MeckMan2025/LawnBot/electronics/BOM.csv

category | item | qty | spec | notes
motion | goBILDA 5203 Yellow Jacket planetary gearmotor | 2 | 71.2:1, 84 rpm, 8 mm REX shaft, encoder | Part 5203-2402-0071. One per drive wheel.
motion | 8 mm REX shaft extension | 2 | 120 mm long, goBILDA 2101 series | Runs through the axle housing bore to the wheel hub.
motion | 8 mm REX clamping shaft coupler | 2 | REX to REX, max 18 mm OD | Sits inside the axle housing's 20 mm bore. Joins the motor shaft to the extension.
motion | goBILDA Hyper Hub | 2 | 8 mm REX bore, 16 mm M4 pattern | Part 1310-0016-4008. Bolts to the drive wheel's outer web.
motion | RoboClaw 2x15A motor controller | 1 | 2 channels, encoder inputs, USB/serial | One channel per drive wheel.
bearings | 6808-2RS ball bearing | 4 | 40 x 52 x 7 | Two per drive wheel, in the printed hub.
bearings | 6004-2RS ball bearing | 4 | 20 x 42 x 12 | Two per caster spindle tower.
bearings | 51104 thrust bearing | 2 | 20 x 35 x 10 | One per caster, between the yoke crown and the boom arm pad.
bearings | 608-2RS ball bearing | 4 | 8 x 22 x 7 | Two per caster wheel.
compute | Raspberry Pi 5 | 1 | 8 GB, with active cooler and 64 GB microSD | Runs the robot software.
compute | 5 V 5 A buck converter | 1 | 12 V in, 5 V 5 A out, USB-C or screw terminals | Powers the Pi 5. Pololu D36V50F5 or similar.
sensing | Luxonis OAK-D Pro W | 1 | wide FOV, active IR | Obstacle depth, night vision, on-device detection. Mounts on the canopy nose.
sensing | u-blox ZED-F9P RTK GPS board | 1 | SparkFun GPS-RTK2 or Ardusimple simpleRTK2B | 2 cm positioning with NTRIP corrections.
sensing | GPS antenna | 1 | u-blox ANN-MB-00 multi-band, 60 mm puck | Sits in the printed cup on the mast.
sensing | BNO085 IMU breakout | 1 | I2C | Heading and motion.
sensing | Raspberry Pi Camera Module 3 Wide | 1 | with 300 mm ribbon cable | In the pan-tilt housing.
sensing | IR illuminator | 1 | 850 nm, 12 V, 10 mm LED or small board | Beside the camera window.
sensing | Subminiature microswitch | 2 | 20 x 10 x 6.5 mm, lever | In the bumper carrier pockets.
motion | Standard-size servo | 2 | 20 kg.cm, 40 x 20 x 40 mm, metal gear | Pan and tilt.
power | LiFePO4 battery | 1 | 12.8 V 20 Ah, max 180 x 150 x 75 mm, built-in BMS | Lies flat in the tray on the chassis lid.
power | LiFePO4 charger | 1 | 14.6 V, 5 A or more | For the dock supply.
power | Mushroom E-stop button | 1 | 22 mm, NC contact | On the canopy roof, rear right.
power | Automotive relay | 1 | 12 V coil, 30 A contacts | E-stop cuts motor power through this.
power | Inline fuse holder and fuses | 1 | 30 A blade fuse | Battery positive lead.
power | Spring contact plates | 2 | 10 x 30 mm, gold or nickel plated | In the charge port housing; mate with the dock block.
power | Copper or brass contact strips | 2 | 20 x 4 mm | In the dock contact block.
power | XT60 connectors | 4 | pairs | Battery and motor power.
power | WAGO 221 lever connectors | 10 | 3 and 5 way | Power distribution.
io | 12 V LED strip | 1 | 180 mm, warm white, IP65 | In the light bar housing.
io | Piezo buzzer | 1 | 12 V, 12 mm | Through the light bar housing.
io | PG9 cable glands | 5 | nylon, 4 to 8 mm cable | Enclosure walls.
io | Gamepad | 1 | Bluetooth or USB | Teleop during setup.
fasteners | M12 x 180 hex bolt with nylock nut and washers | 2 | 8.8 steel | Caster spindle core.
fasteners | M8 x 140 hex bolt with nylock nut and washers | 2 | 8.8 steel | Caster axle.
fasteners | M6 x 50 socket cap | 8 | stainless | Caster towers into the arm pad inserts.
fasteners | M5 x 45 socket cap with nut | 12 | stainless | Cross member splices and arm-to-cross bolts.
fasteners | M5 x 35 socket cap with nut | 8 | stainless | Axle housing through the wall into the motor mount.
fasteners | M5 x 30 socket cap | 4 | stainless | Riser tops into the cross member.
fasteners | M5 x 25 socket cap | 4 | stainless | Mast base through the roof into the standoff.
fasteners | M5 x 20 socket cap with nut | 32 | stainless | Chassis module seams (16) and dock tiles (16).
fasteners | M5 x 16 socket cap | 24 | stainless | Riser, leg and brace feet; deck to cross members.
fasteners | M4 x 45 socket cap with nut | 6 | stainless | Mast cross bolts.
fasteners | M4 x 16 socket cap | 24 | stainless | Motor faces, enclosure lid, fenders.
fasteners | M4 x 12 socket cap | 70 | stainless | Chassis lids, skirts, enclosure feet, standoff, tray, hood.
fasteners | M3 x 8 socket cap | 40 | stainless | Canopy splice strips.
fasteners | M3 x 10 socket cap | 16 | stainless | E-stop housing, light bar, tilt bracket, board adapter plates.
fasteners | M2.5 x 8 socket cap | 4 | stainless | Raspberry Pi 5.
fasteners | M2 x 6 socket cap | 4 | stainless | Camera module.
fasteners | Heat-set insert M2.5 | 4 | 3.4 mm hole | Enclosure floor (Pi).
fasteners | Heat-set insert M3 | 70 | 4.0 mm hole | Enclosure grid, canopy splices, camera housing.
fasteners | Heat-set insert M4 | 120 | 5.6 mm hole | Lids, deck grid, skirts, tub bosses, fenders.
fasteners | Heat-set insert M5 | 70 | 6.4 mm hole | Lids, cross members, legs, standoff, dock tiles.
fasteners | Heat-set insert M6 | 8 | 8.0 mm hole | Arm pads for the caster towers.
fasteners | Compression spring | 2 | 10 mm OD, 30 mm long, light | Bumper return.
fasteners | M5 x 30 shoulder bolt | 2 | 6 mm shoulder | Bumper carrier slides on these.
fasteners | Nylon strap with buckle | 2 | 25 mm wide | Battery.
fasteners | Ground stake | 4 | 10 mm, 200 mm long | Dock tiles.
misc | AprilTag print | 1 | tag36h11, 120 mm, laminated | In the dock tag frame.
misc | Silicone sealant | 1 | clear, outdoor | Camera window, gland threads.
misc | Dielectric grease | 1 | small tube | Charge contacts.
