MeckMan2025/LawnBot/cad/out/assembly.step

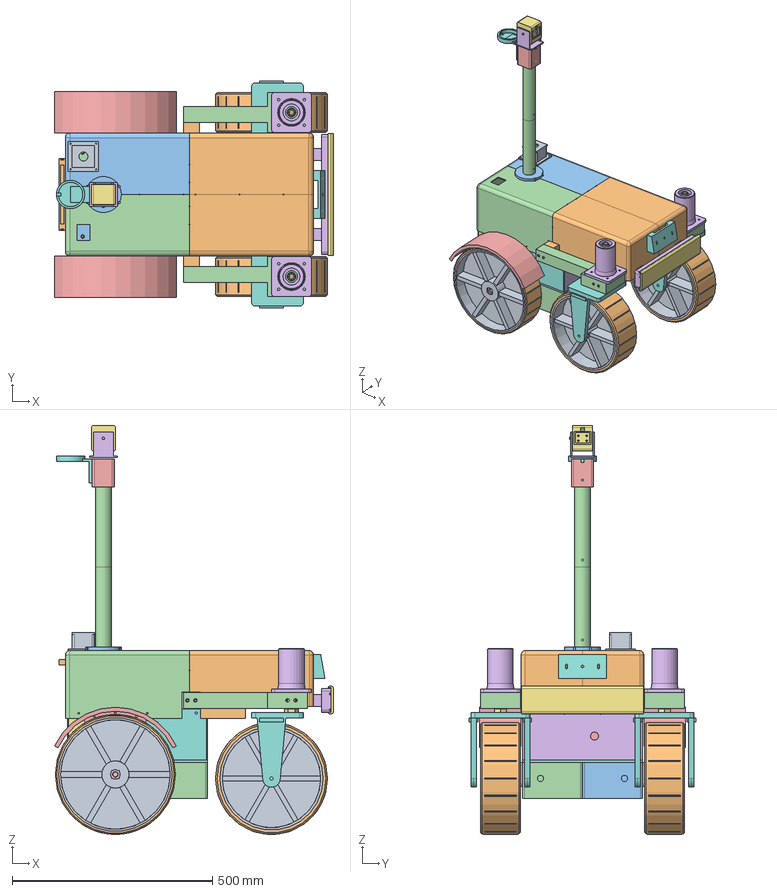
[picture p1: CAD file, 2026-10-13]
cad/out/assembly.step
697.3 x 566.0 x 1022.0 mm
rear_left
rear_right
front_left
front_right
motor_mount_left
axle_housing_left
motor_mount_right
axle_housing_right
lid_rear
lid_front
wheel_left
tread_left
wheel_right
tread_right
leg_left
leg_right
battery_tray
skirt_rear
skirt_front
skirt_side_rear_left
skirt_side_front_left
skirt_side_rear_right
skirt_side_front_right
riser_left
cross_rear_left
riser_right
cross_rear_right
brace_left
boom_arm_left
brace_right
boom_arm_right
cross_front_left
cross_front_right
tower_left
sleeve_left
fork_left
caster_rim_left
caster_tire_left
tower_right
sleeve_right
fork_right
caster_rim_right
caster_tire_right
deck_rear_right
deck_rear_left
deck_front_right
deck_front_left
enclosure_tub
enclosure_lid
mast_standoff
canopy_front_left
canopy_front_right
canopy_rear_left
canopy_rear_right
fender_left
fender_right
bumper_carrier
bumper_skin
oak_mount
estop_housing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
