MeckMan2025/LawnBot/cad/out/step/canopy_splice_roof_y.step

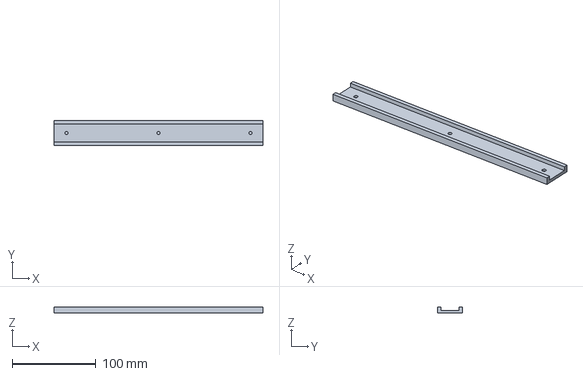
[picture p2: CAD file, 2026-10-12]
cad/out/step/canopy_splice_roof_y.step
250.0 x 30.0 x 7.00 mm
