MeckMan2025/LawnBot/cad/out/step/mast_standoff.step

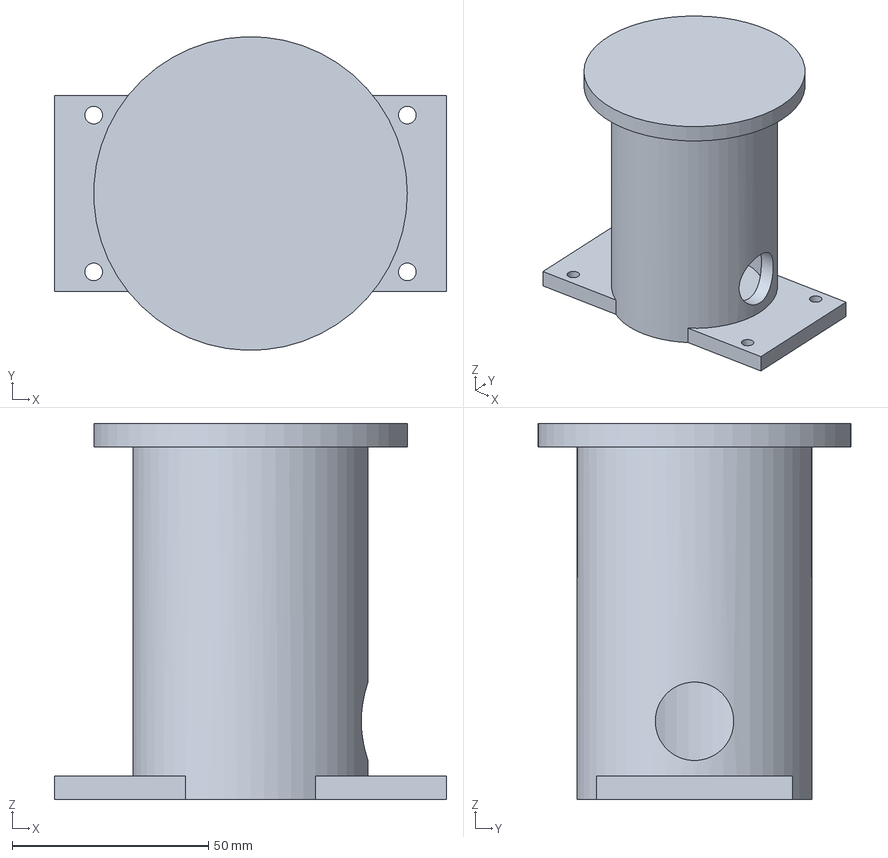
[picture p3: CAD file, 2026-10-12]
cad/out/step/mast_standoff.step
100.0 x 80.0 x 96.0 mm
