MeckMan2025/LawnBot/cad/out/step/riser_brace.step

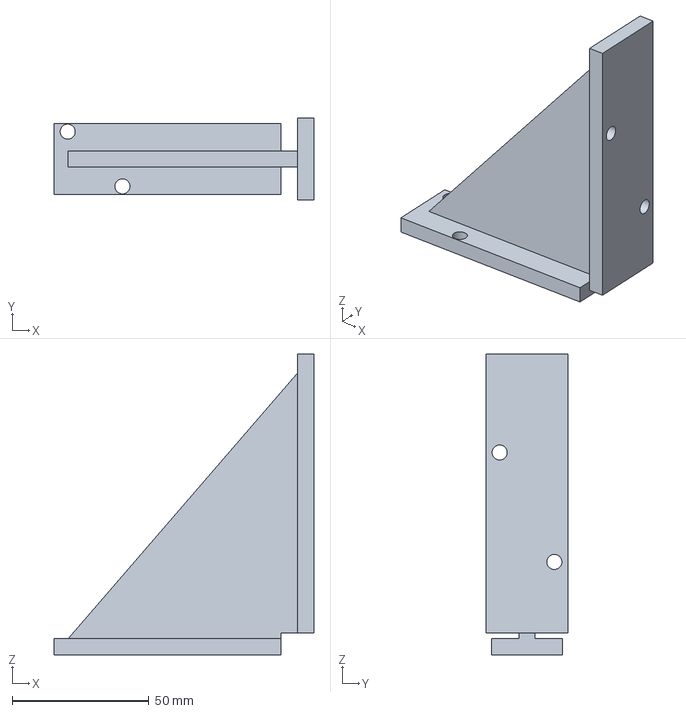
[picture p4: CAD file, 2026-10-12]
cad/out/step/riser_brace.step
95.0 x 30.0 x 110.0 mm
