MeckMan2025/LawnBot/cad/out/step/caster_axle_spacer_inner.step

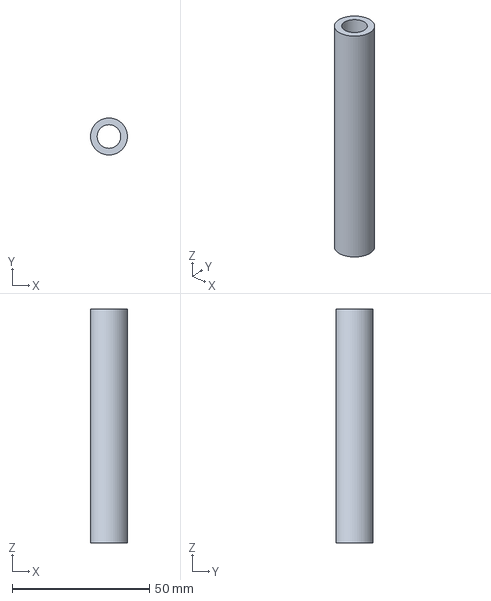
[picture p5: CAD file, 2026-10-12]
cad/out/step/caster_axle_spacer_inner.step
13.5 x 13.5 x 85.4 mm
