MeckMan2025/LawnBot/cad/out/step/drive_wheel.step

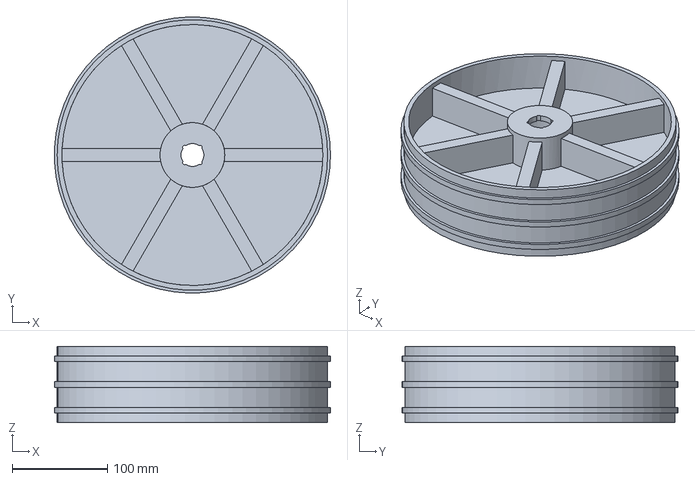
[picture p6: CAD file, 2026-10-12]
cad/out/step/drive_wheel.step
289.8 x 289.9 x 80.0 mm
