MeckMan2025/LawnBot/cad/out/step/dock_tile.step

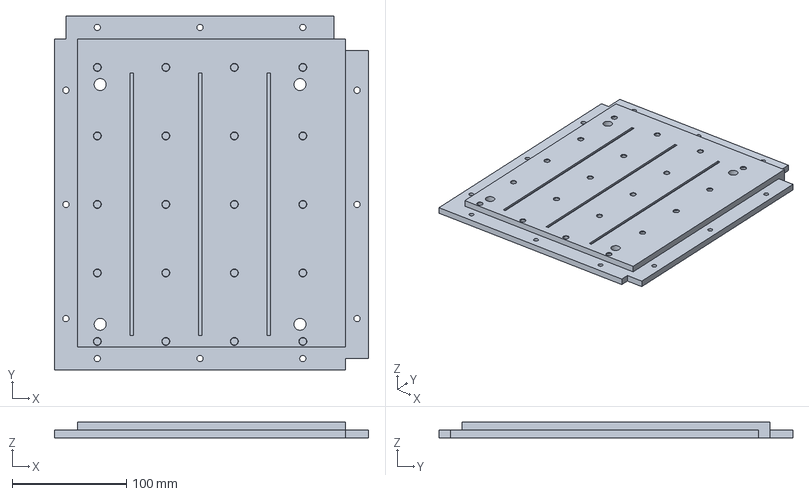
[picture p7: CAD file, 2026-10-12]
cad/out/step/dock_tile.step
275.0 x 310.0 x 14.0 mm
