MeckMan2025/LawnBot/cad/out/step/dock_rail_half.step

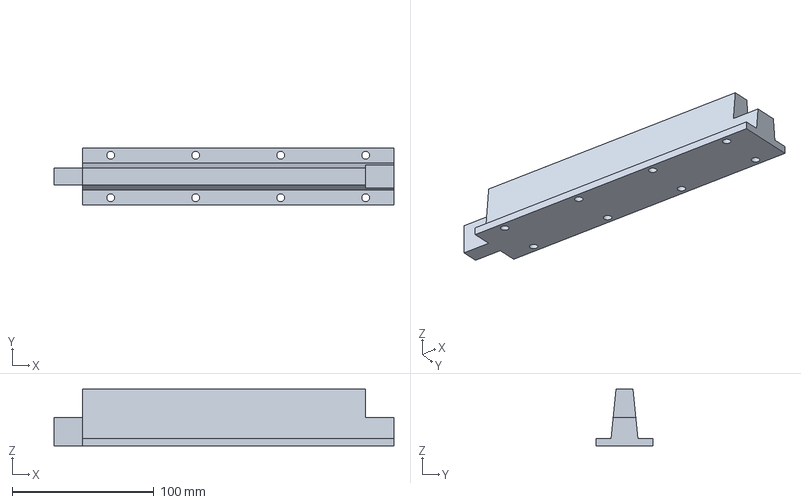
[picture p8: CAD file, 2026-10-12]
cad/out/step/dock_rail_half.step
240.0 x 40.0 x 40.0 mm
