MeckMan2025/LawnBot/cad/out/step/gps_mount.step

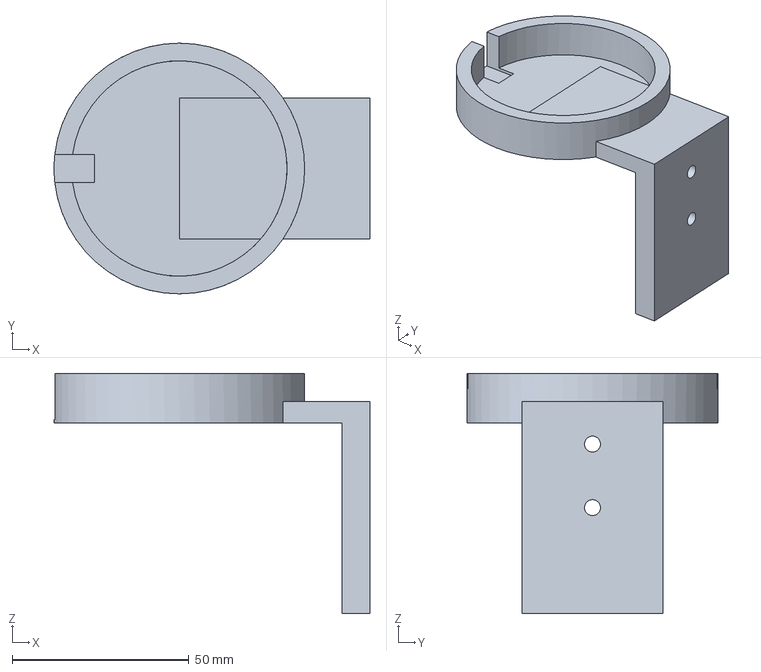
[picture p9: CAD file, 2026-10-12]
cad/out/step/gps_mount.step
89.5 x 71.0 x 68.0 mm
