MeckMan2025/LawnBot/cad/out/step/battery_tray.step

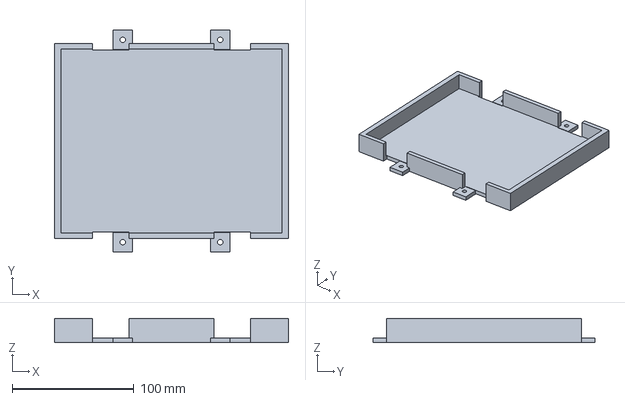
[picture p10: CAD file, 2026-10-12]
cad/out/step/battery_tray.step
192.0 x 182.0 x 20.0 mm
