MeckMan2025/LawnBot/cad/out/step/canopy_front_right.step

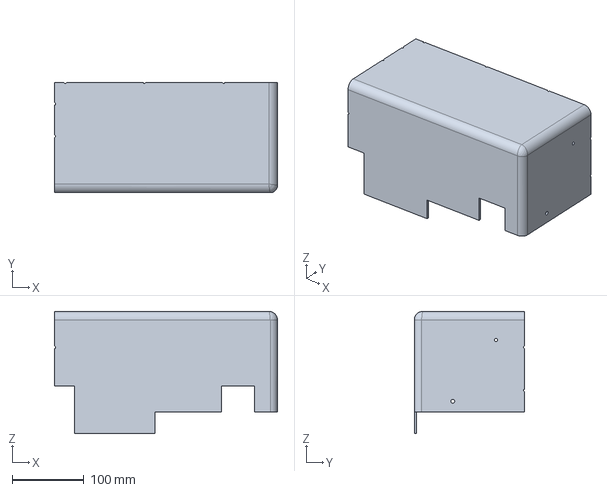
[picture p11: CAD file, 2026-10-12]
cad/out/step/canopy_front_right.step
310.0 x 153.5 x 170.0 mm
