MeckMan2025/LawnBot/cad/out/step/boom_cross_front_half.step

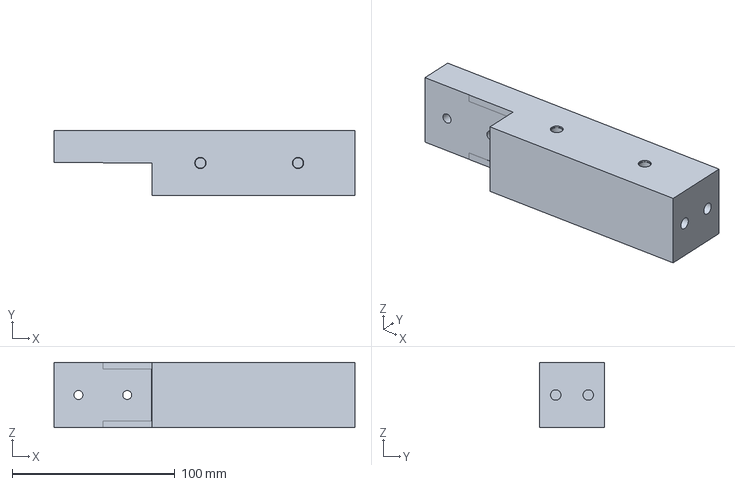
[picture p12: CAD file, 2026-10-12]
cad/out/step/boom_cross_front_half.step
185.0 x 40.0 x 40.0 mm
