MeckMan2025/LawnBot/cad/out/step/tilt_bracket.step

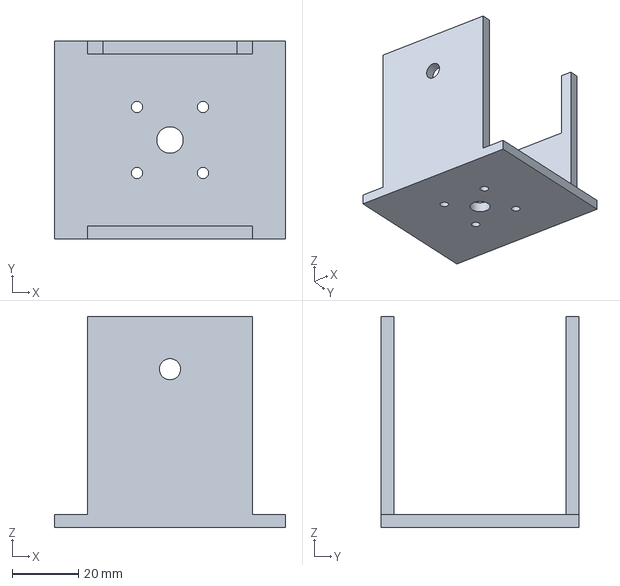
[picture p13: CAD file, 2026-10-12]
cad/out/step/tilt_bracket.step
70.0 x 60.0 x 64.0 mm
