MeckMan2025/LawnBot/cad/out/step/skirt_side_front.step

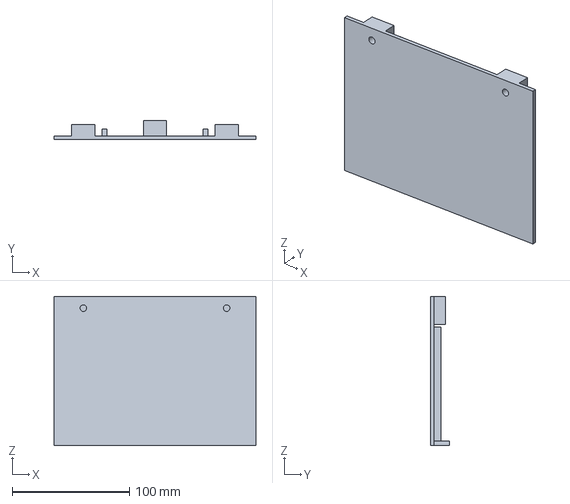
[picture p14: CAD file, 2026-10-12]
cad/out/step/skirt_side_front.step
172.0 x 16.5 x 127.0 mm
