MeckMan2025/LawnBot/cad/out/step/chassis_lid_rear.step

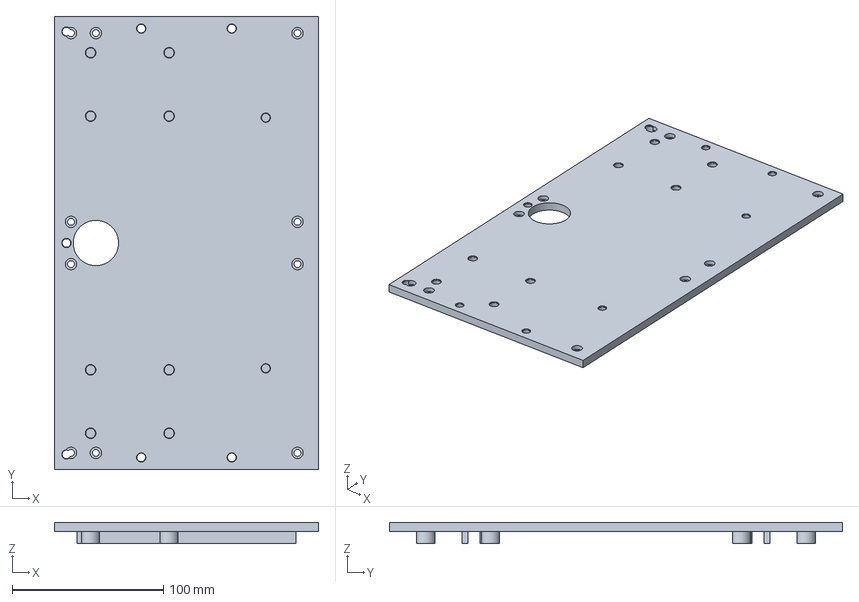
[picture p15: CAD file, 2026-10-12]
cad/out/step/chassis_lid_rear.step
175.0 x 300.0 x 14.0 mm
