MeckMan2025/LawnBot/cad/out/step/chassis_module_front_left.step

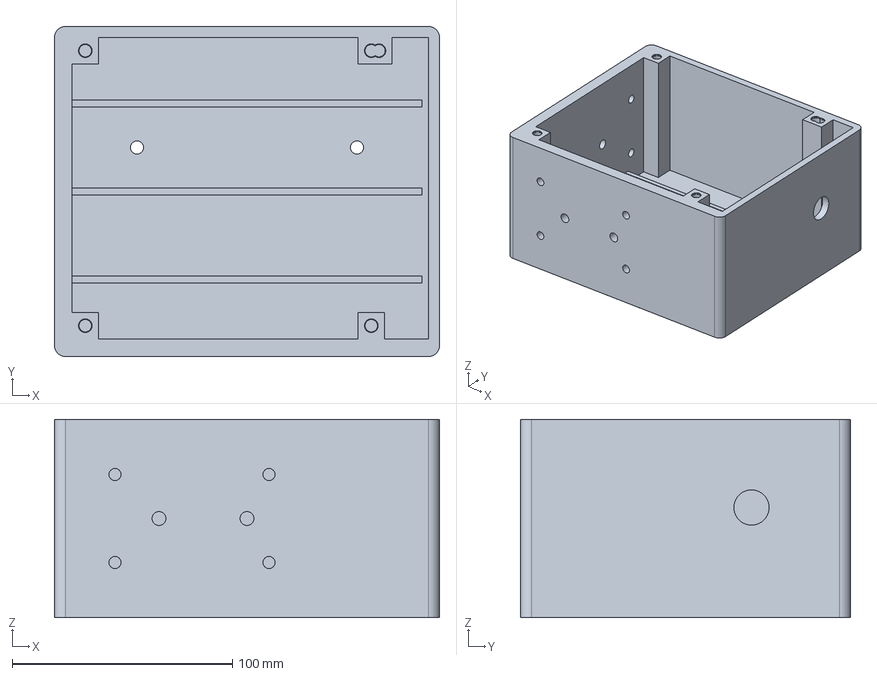
[picture p16: CAD file, 2026-10-12]
cad/out/step/chassis_module_front_left.step
175.0 x 150.0 x 90.0 mm
