MeckMan2025/LawnBot/cad/out/step/canopy_rear_left.step

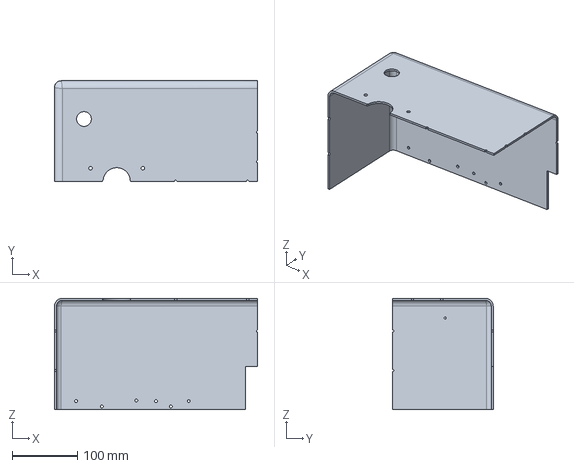
[picture p18: CAD file, 2026-10-12]
cad/out/step/canopy_rear_left.step
310.0 x 153.5 x 170.0 mm
