MeckMan2025/LawnBot/cad/out/step/fender.step

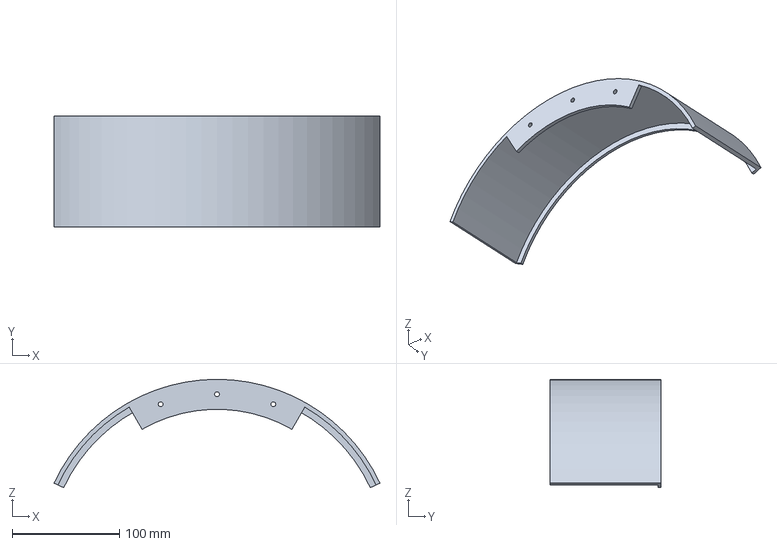
[picture p19: CAD file, 2026-10-12]
cad/out/step/fender.step
304.5 x 104.0 x 101.2 mm
