MeckMan2025/LawnBot/cad/out/step/enclosure_tub.step

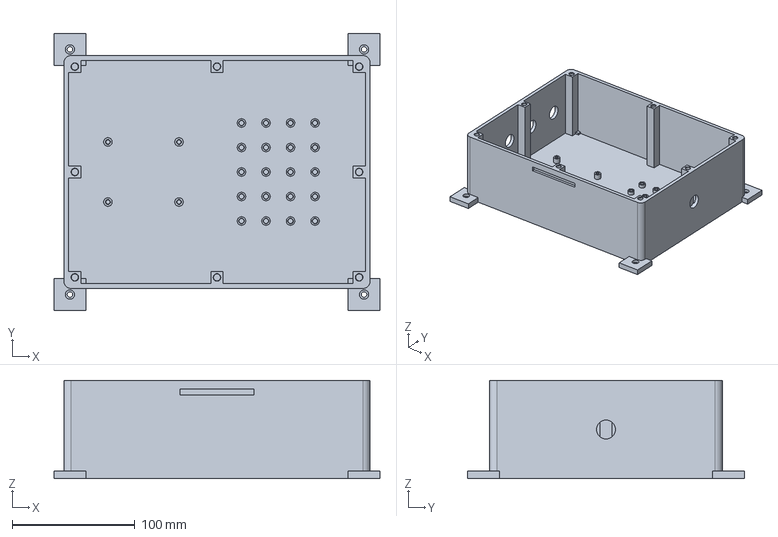
[picture p20: CAD file, 2026-10-12]
cad/out/step/enclosure_tub.step
266.0 x 226.0 x 80.0 mm
