MeckMan2025/LawnBot/cad/out/step/estop_housing.step

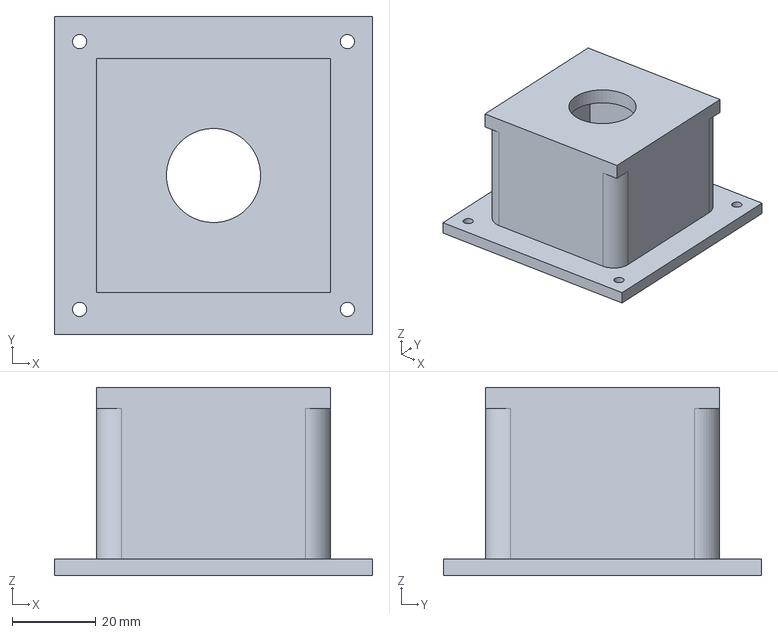
[picture p21: CAD file, 2026-10-12]
cad/out/step/estop_housing.step
76.0 x 76.0 x 45.0 mm
