MeckMan2025/LawnBot/cad/out/step/pan_base.step

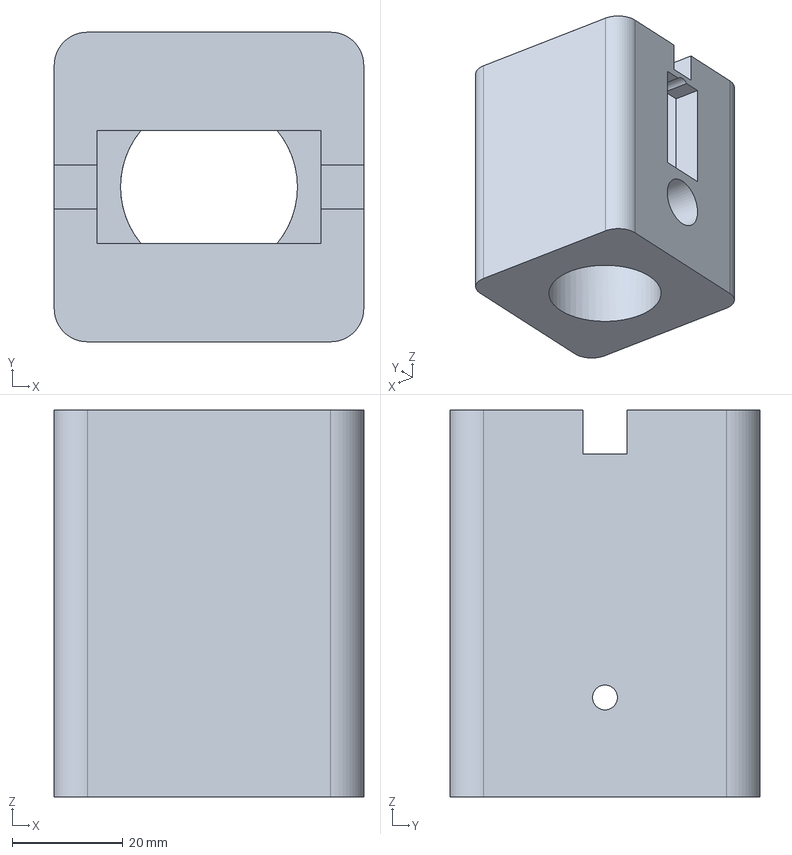
[picture p22: CAD file, 2026-10-12]
cad/out/step/pan_base.step
56.0 x 56.0 x 70.0 mm
