MeckMan2025/LawnBot/cad/out/step/dock_contact_block.step

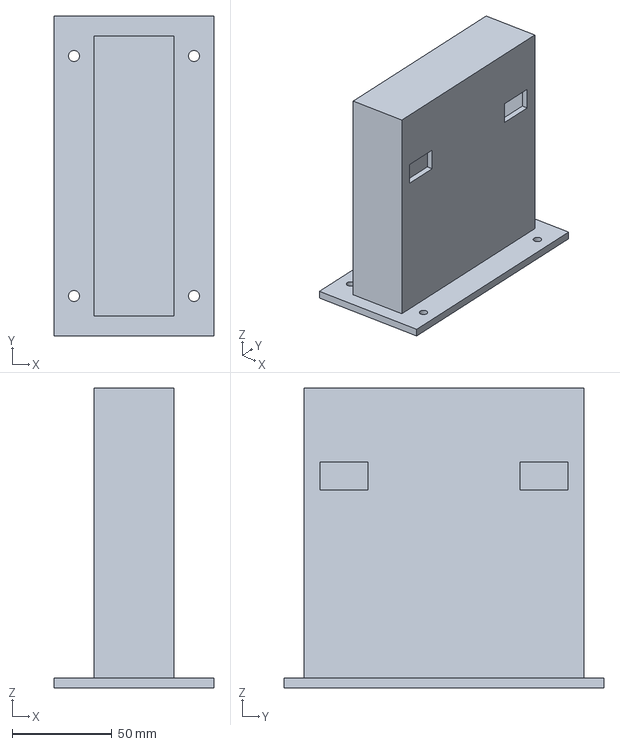
[picture p23: CAD file, 2026-10-12]
cad/out/step/dock_contact_block.step
80.0 x 160.0 x 150.0 mm
