MeckMan2025/LawnBot/cad/out/step/caster_rim.step

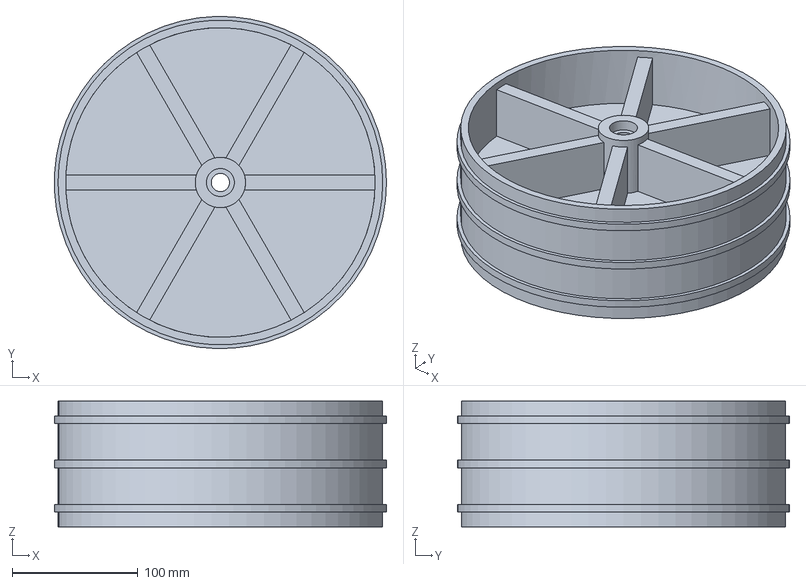
[picture p24: CAD file, 2026-10-12]
cad/out/step/caster_rim.step
263.8 x 263.9 x 100.0 mm
