MeckMan2025/LawnBot/cad/out/step/canopy_splice_wall.step

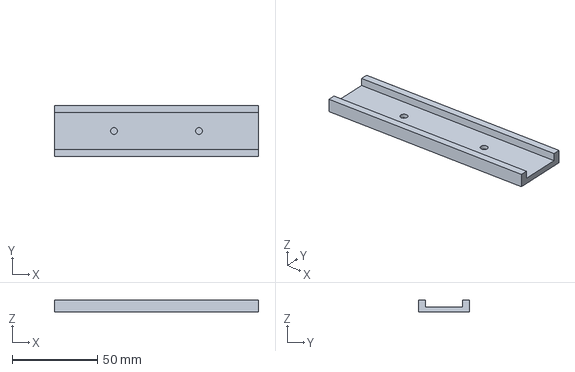
[picture p25: CAD file, 2026-10-12]
cad/out/step/canopy_splice_wall.step
120.0 x 30.0 x 7.00 mm
