MeckMan2025/LawnBot/cad/out/step/caster_fork.step

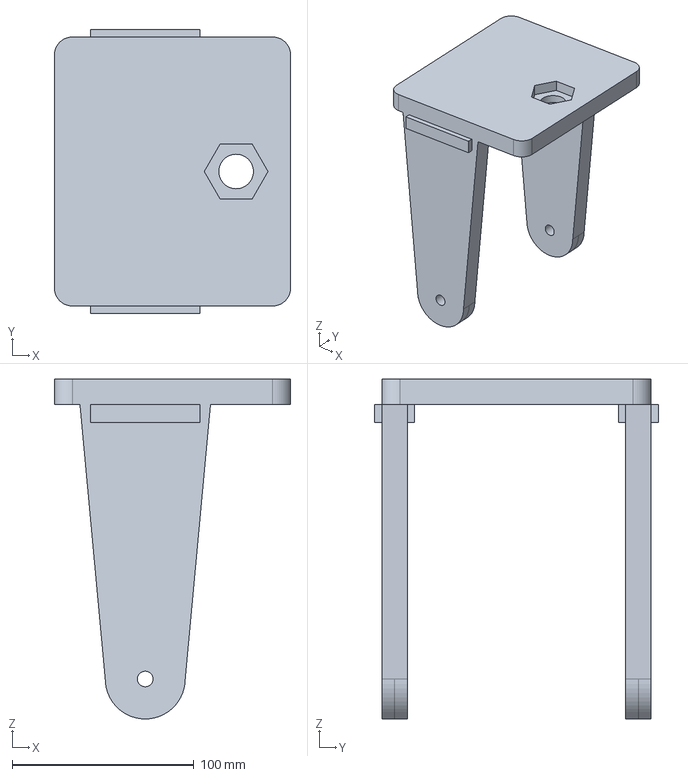
[picture p26: CAD file, 2026-10-12]
cad/out/step/caster_fork.step
130.0 x 156.0 x 187.0 mm
