MeckMan2025/LawnBot/cad/out/step/drive_axle_housing.step

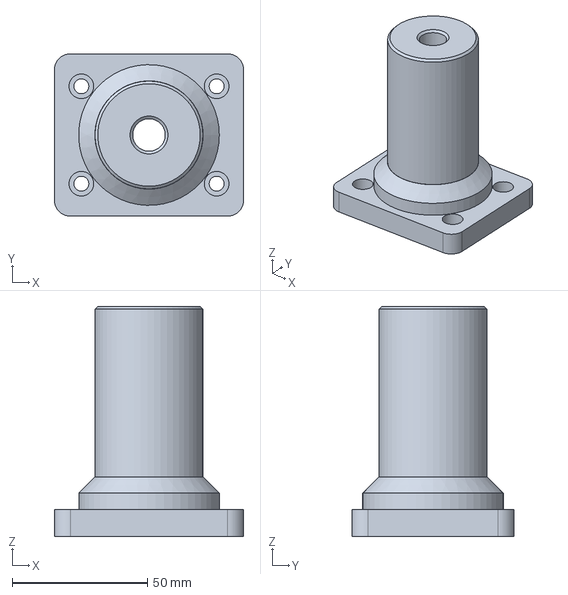
[picture p27: CAD file, 2026-10-12]
cad/out/step/drive_axle_housing.step
70.0 x 60.0 x 85.0 mm
