MeckMan2025/LawnBot/cad/out/step/boom_cross_rear_half.step

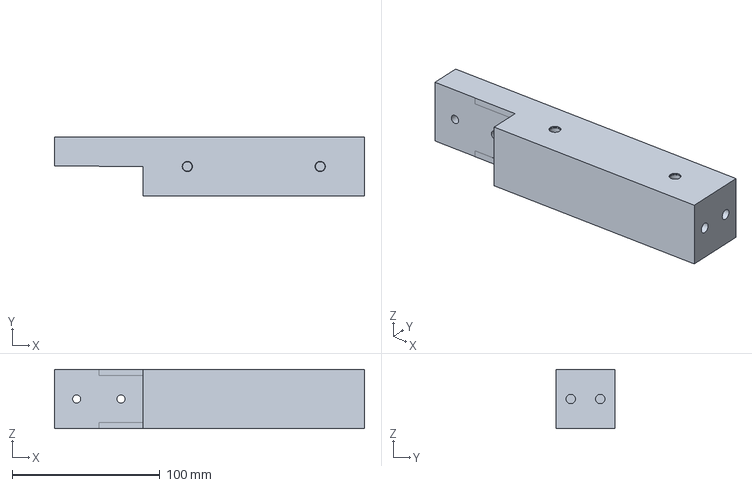
[picture p28: CAD file, 2026-10-12]
cad/out/step/boom_cross_rear_half.step
210.0 x 40.0 x 40.0 mm
