MeckMan2025/LawnBot/cad/out/step/alignment_dowel.step

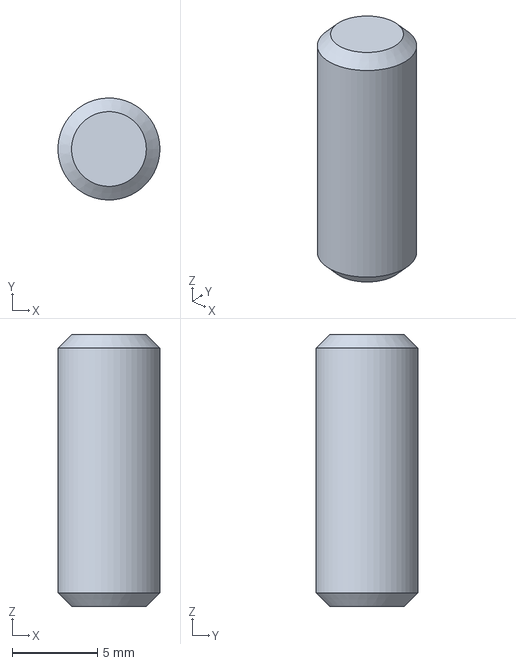
[picture p29: CAD file, 2026-10-12]
cad/out/step/alignment_dowel.step
5.99 x 6.00 x 16.0 mm
