MeckMan2025/LawnBot/cad/out/step/camera_cover.step

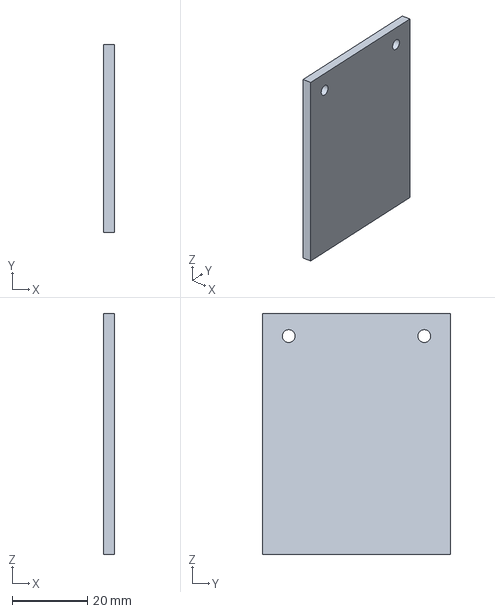
[picture p30: CAD file, 2026-10-12]
cad/out/step/camera_cover.step
3.00 x 50.0 x 64.0 mm
