MeckMan2025/LawnBot/cad/out/step/mast_base.step

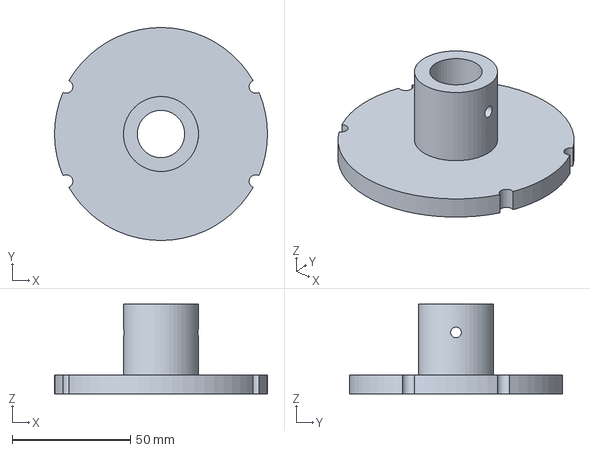
[picture p31: CAD file, 2026-10-12]
cad/out/step/mast_base.step
90.0 x 90.0 x 38.0 mm
