MeckMan2025/LawnBot/cad/out/step/rear_deck_leg.step

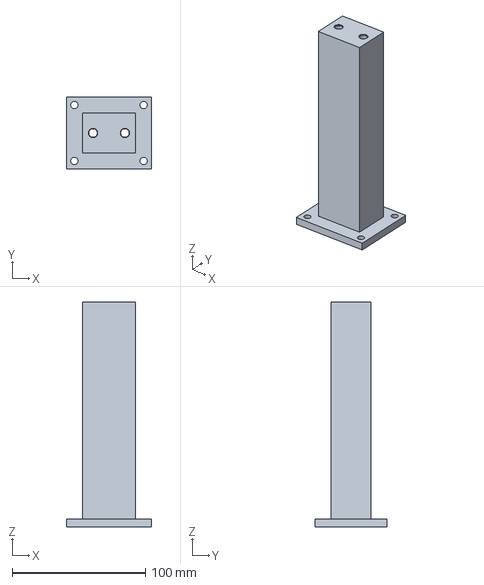
[picture p32: CAD file, 2026-10-12]
cad/out/step/rear_deck_leg.step
64.0 x 54.0 x 169.0 mm
