MeckMan2025/LawnBot/cad/out/step/bumper_skin.step

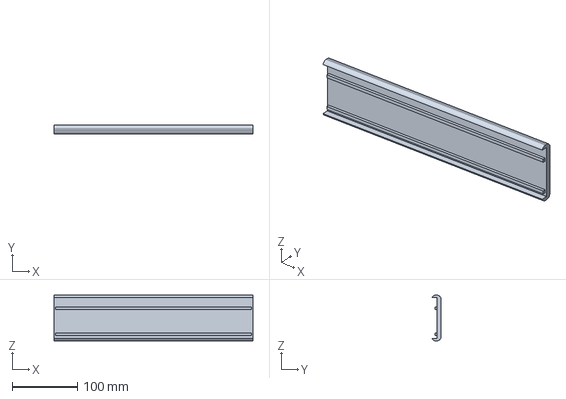
[picture p33: CAD file, 2026-10-12]
cad/out/step/bumper_skin.step
304.0 x 13.7 x 70.0 mm
