MeckMan2025/LawnBot/cad/out/step/enclosure_lid.step

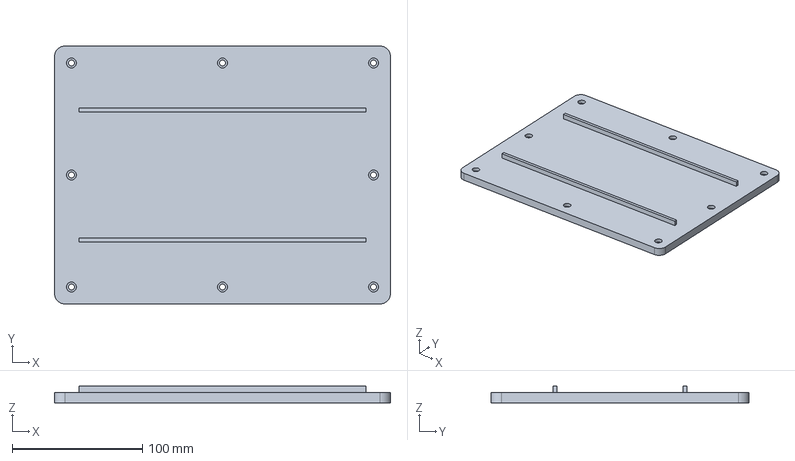
[picture p34: CAD file, 2026-10-12]
cad/out/step/enclosure_lid.step
258.0 x 198.0 x 13.0 mm
