MeckMan2025/LawnBot/cad/out/step/caster_tire.step

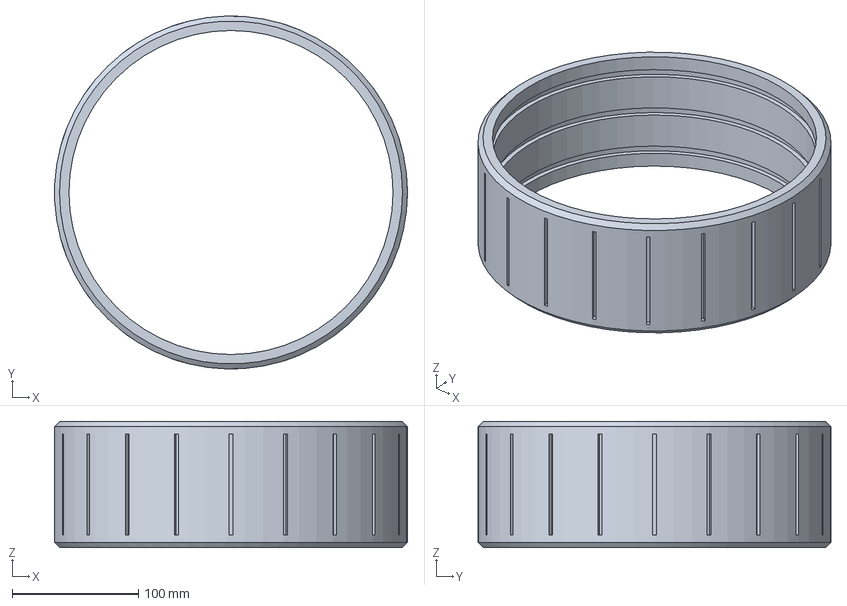
[picture p35: CAD file, 2026-10-12]
cad/out/step/caster_tire.step
280.0 x 280.0 x 100.0 mm
