MeckMan2025/LawnBot/cad/out/step/camera_housing.step

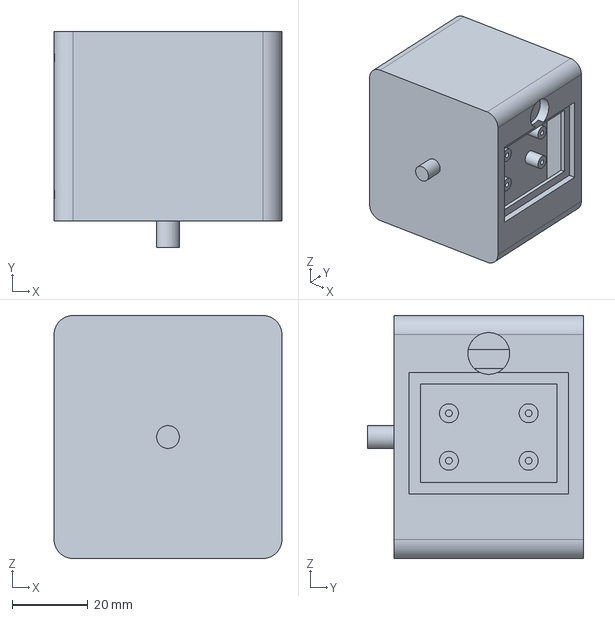
[picture p36: CAD file, 2026-10-12]
cad/out/step/camera_housing.step
60.0 x 57.0 x 64.0 mm
