MeckMan2025/LawnBot/cad/out/step/contact_pad_carrier.step

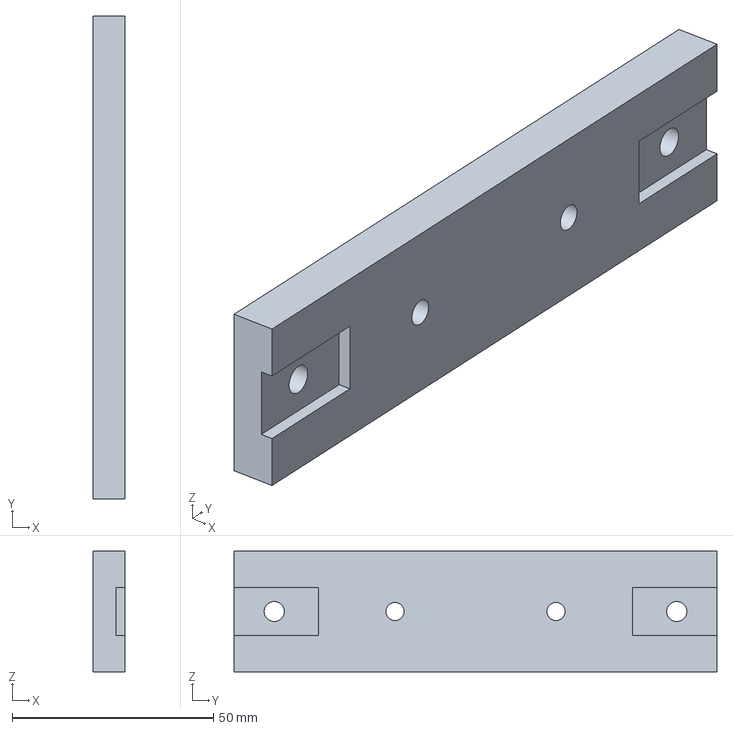
[picture p37: CAD file, 2026-10-12]
cad/out/step/contact_pad_carrier.step
8.00 x 120.0 x 30.0 mm
