MeckMan2025/LawnBot/cad/out/step/light_bar_housing.step

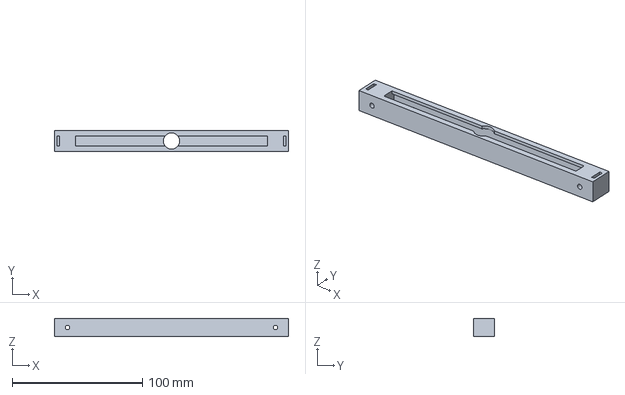
[picture p38: CAD file, 2026-10-12]
cad/out/step/light_bar_housing.step
180.0 x 16.0 x 14.0 mm
