MeckMan2025/LawnBot/cad/out/step/deck_front_right.step

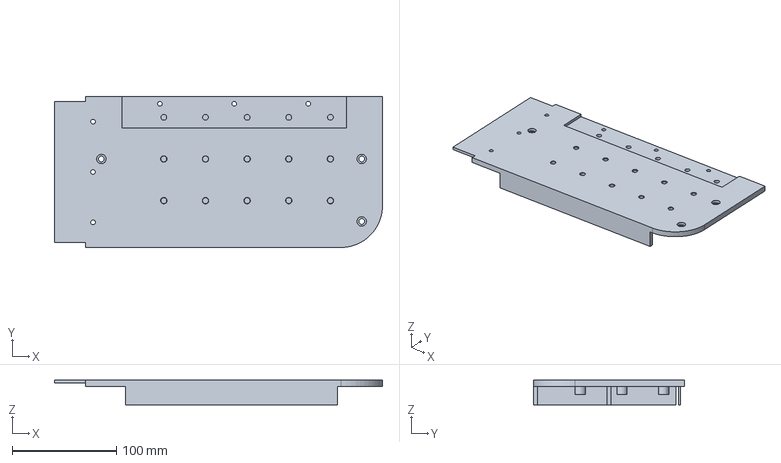
[picture p39: CAD file, 2026-10-12]
cad/out/step/deck_front_right.step
315.0 x 145.0 x 24.0 mm
