MeckMan2025/LawnBot/cad/out/step/boom_arm_right.step

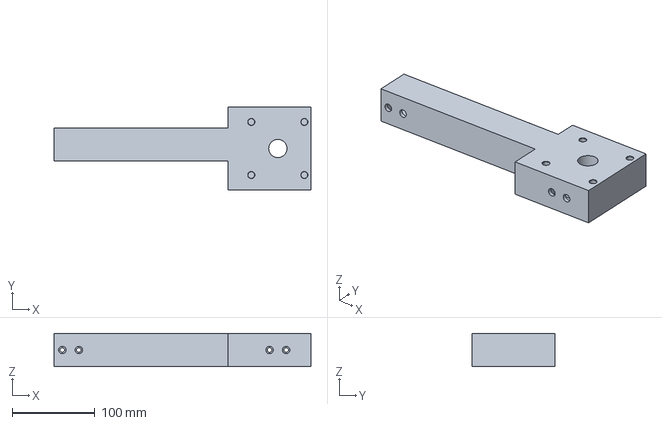
[picture p40: CAD file, 2026-10-12]
cad/out/step/boom_arm_right.step
310.0 x 100.0 x 40.0 mm
