MeckMan2025/LawnBot/cad/out/step/bearing_spacer.step

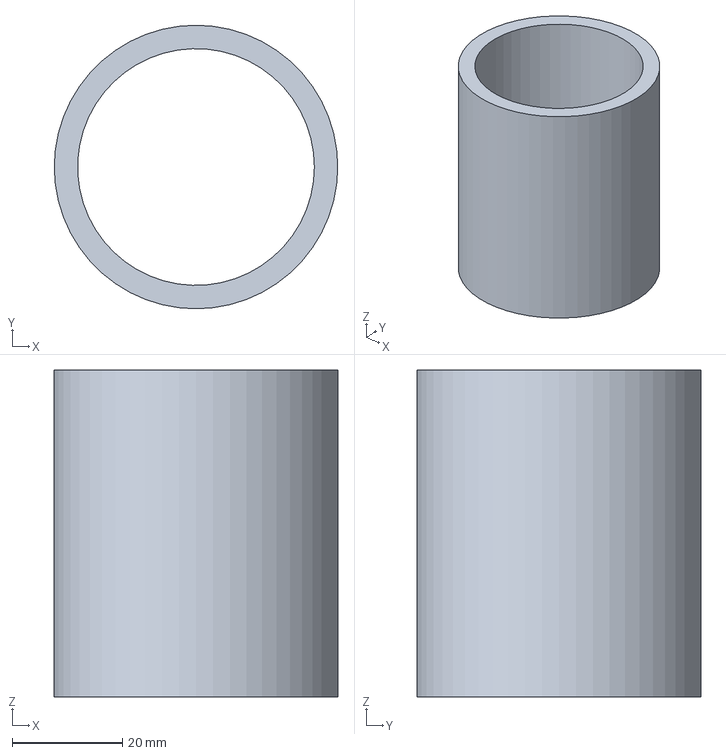
[picture p41: CAD file, 2026-10-12]
cad/out/step/bearing_spacer.step
51.5 x 51.5 x 59.4 mm
