MeckMan2025/LawnBot/cad/out/step/oak_hood.step

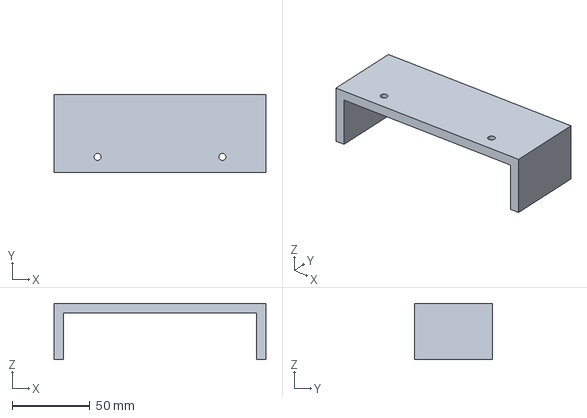
[picture p42: CAD file, 2026-10-12]
cad/out/step/oak_hood.step
136.0 x 50.0 x 36.0 mm
