MeckMan2025/LawnBot/cad/out/step/bumper_carrier.step

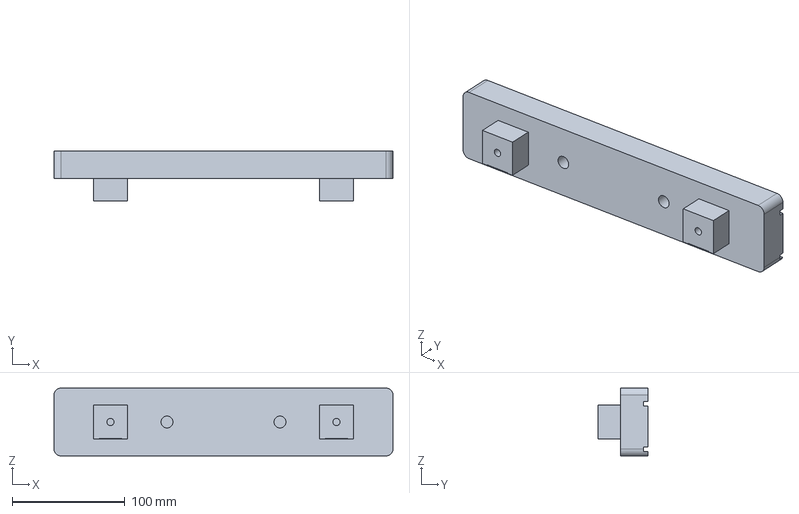
[picture p43: CAD file, 2026-10-12]
cad/out/step/bumper_carrier.step
300.0 x 44.0 x 60.0 mm
