MeckMan2025/LawnBot/cad/out/step/enclosure_gasket.step

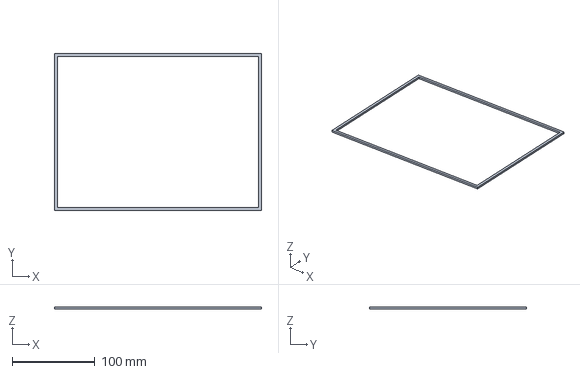
[picture p44: CAD file, 2026-10-12]
cad/out/step/enclosure_gasket.step
249.6 x 189.6 x 2.60 mm
