MeckMan2025/LawnBot/cad/out/step/caster_spindle_tower.step

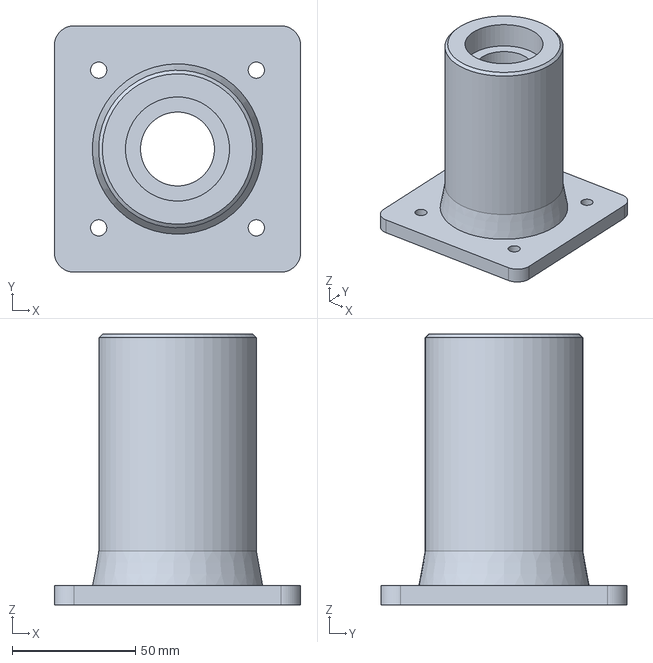
[picture p45: CAD file, 2026-10-12]
cad/out/step/caster_spindle_tower.step
100.0 x 100.0 x 110.0 mm
