MeckMan2025/LawnBot/cad/out/step/charge_port_housing.step

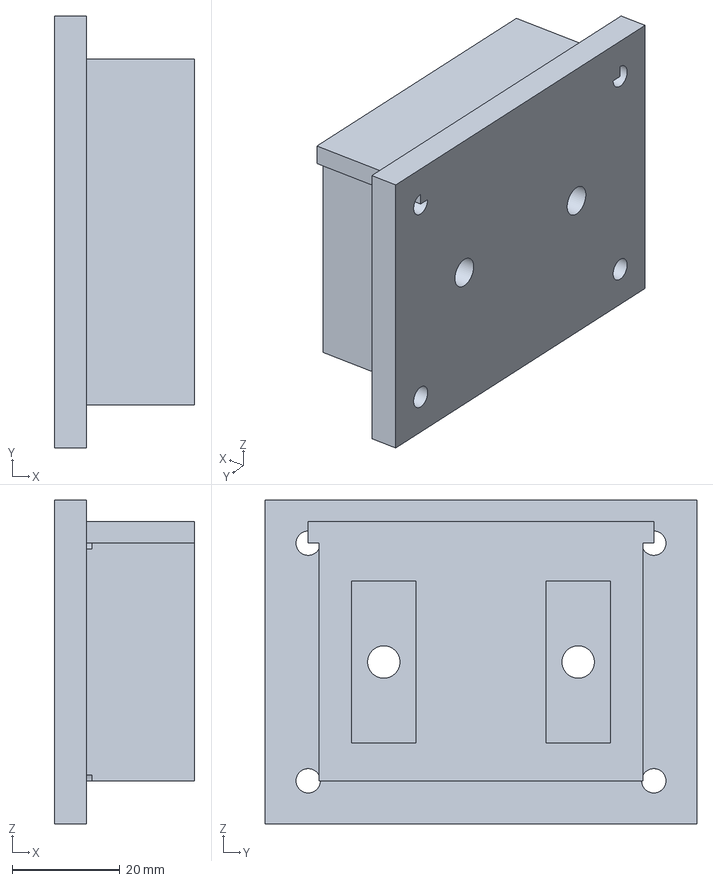
[picture p46: CAD file, 2026-10-12]
cad/out/step/charge_port_housing.step
26.0 x 80.0 x 60.0 mm
