MeckMan2025/LawnBot/cad/out/step/dock_rain_cover.step

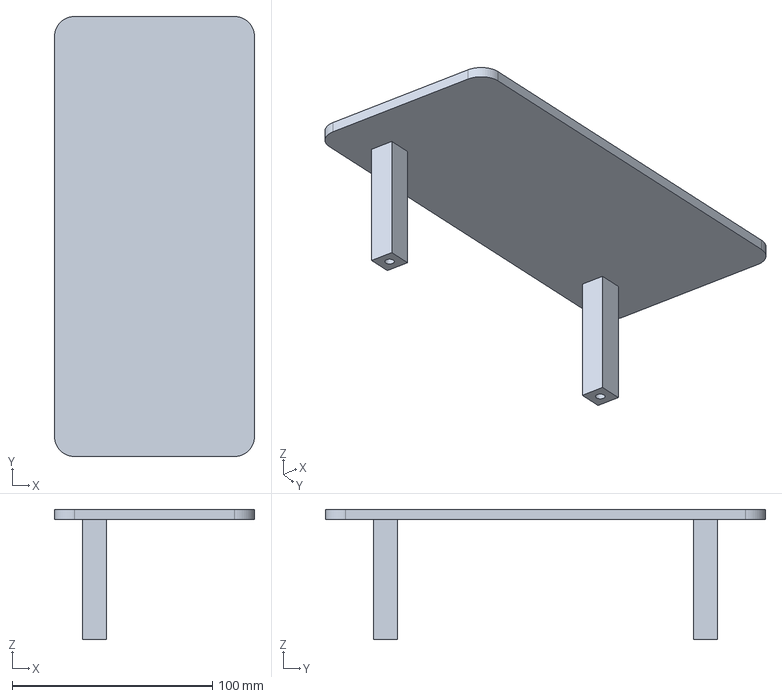
[picture p47: CAD file, 2026-10-12]
cad/out/step/dock_rain_cover.step
100.0 x 220.0 x 65.0 mm
