MeckMan2025/LawnBot/cad/out/step/riser_column.step

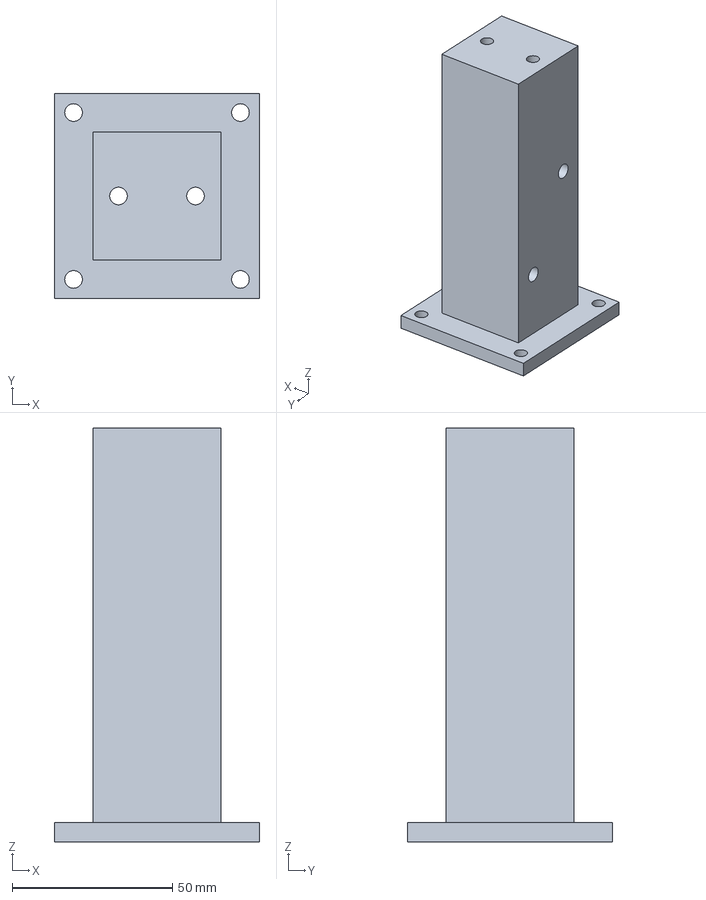
[picture p48: CAD file, 2026-10-12]
cad/out/step/riser_column.step
64.0 x 64.0 x 129.0 mm
