MeckMan2025/LawnBot/cad/out/step/oak_mount.step

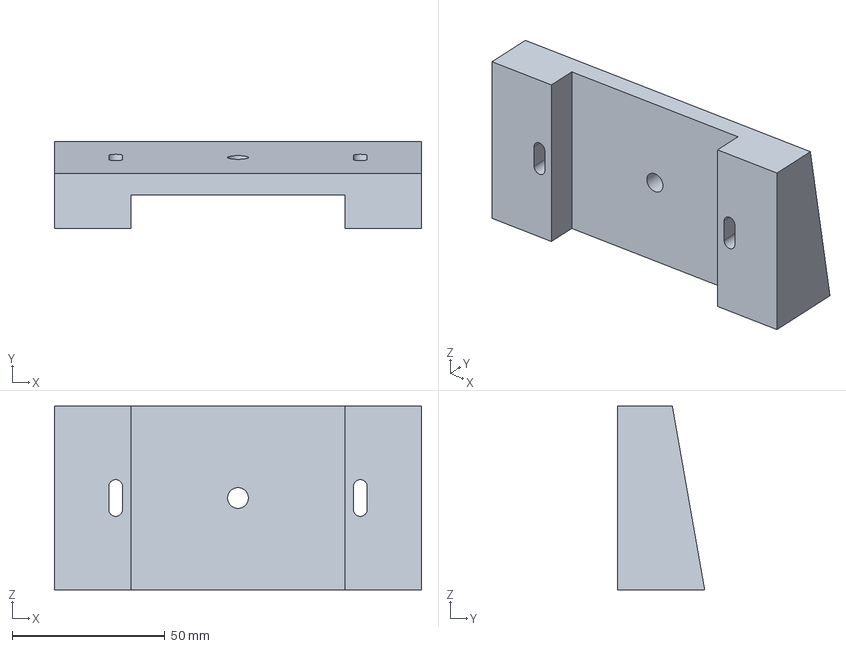
[picture p49: CAD file, 2026-10-12]
cad/out/step/oak_mount.step
120.0 x 28.6 x 60.0 mm
