MeckMan2025/LawnBot/cad/out/step/skirt_side_rear.step

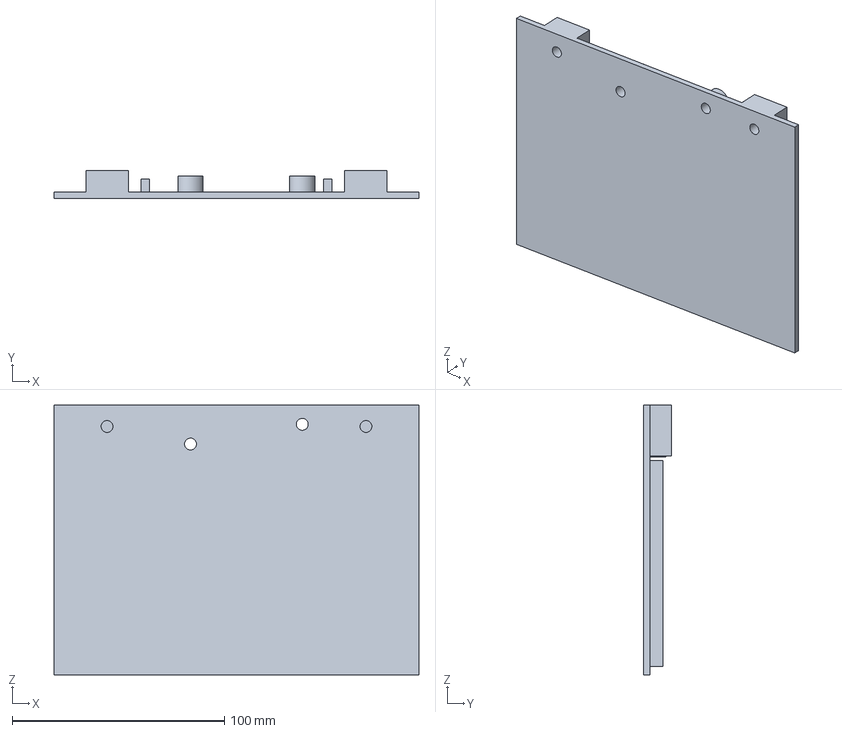
[picture p50: CAD file, 2026-10-12]
cad/out/step/skirt_side_rear.step
172.0 x 13.0 x 127.0 mm
