MeckMan2025/LawnBot/cad/out/step/deck_front_left.step

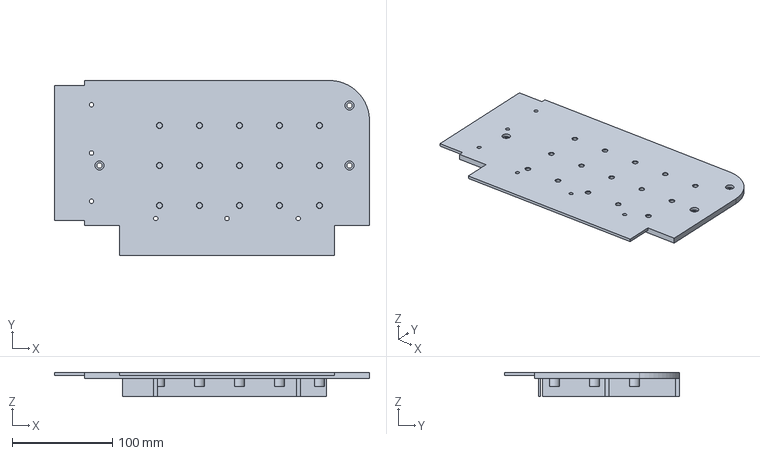
[picture p52: CAD file, 2026-10-12]
cad/out/step/deck_front_left.step
315.0 x 175.0 x 24.0 mm
