MeckMan2025/LawnBot/cad/out/step/dock_tag_frame.step

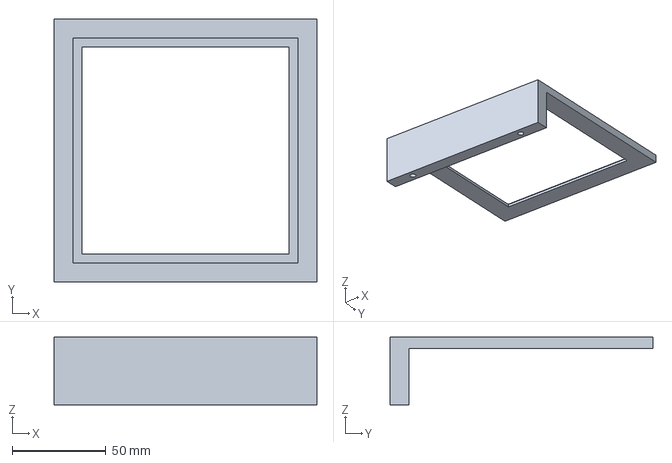
[picture p53: CAD file, 2026-10-12]
cad/out/step/dock_tag_frame.step
140.0 x 140.0 x 36.0 mm
