MeckMan2025/LawnBot/cad/out/step/camera_window.step

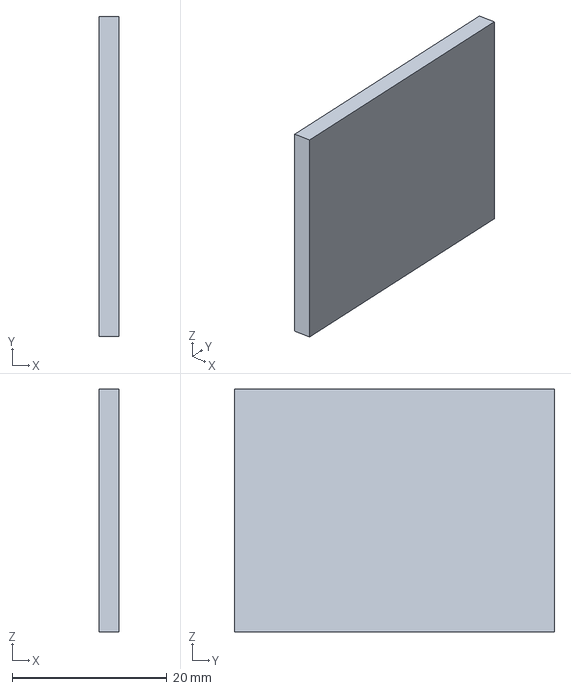
[picture p54: CAD file, 2026-10-12]
cad/out/step/camera_window.step
2.60 x 41.4 x 31.4 mm
