MeckMan2025/LawnBot/cad/out/step/deck_rear_left.step

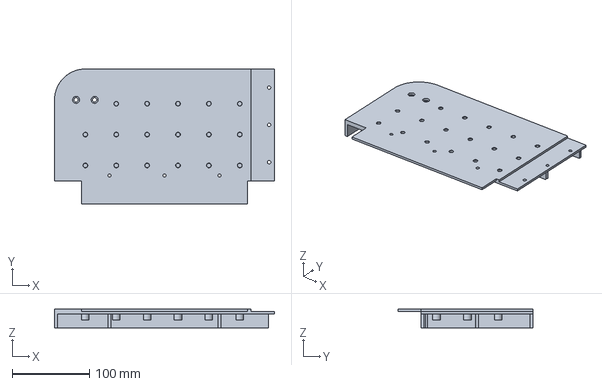
[picture p55: CAD file, 2026-10-12]
cad/out/step/deck_rear_left.step
285.0 x 175.0 x 24.0 mm
