MeckMan2025/LawnBot/cad/out/step/mast_segment.step

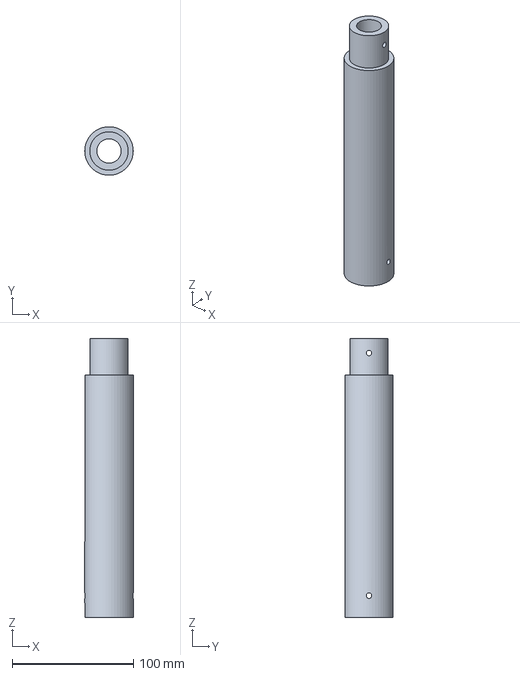
[picture p56: CAD file, 2026-10-12]
cad/out/step/mast_segment.step
40.0 x 40.0 x 230.0 mm
