MeckMan2025/LawnBot/cad/out/step/caster_spindle_sleeve.step

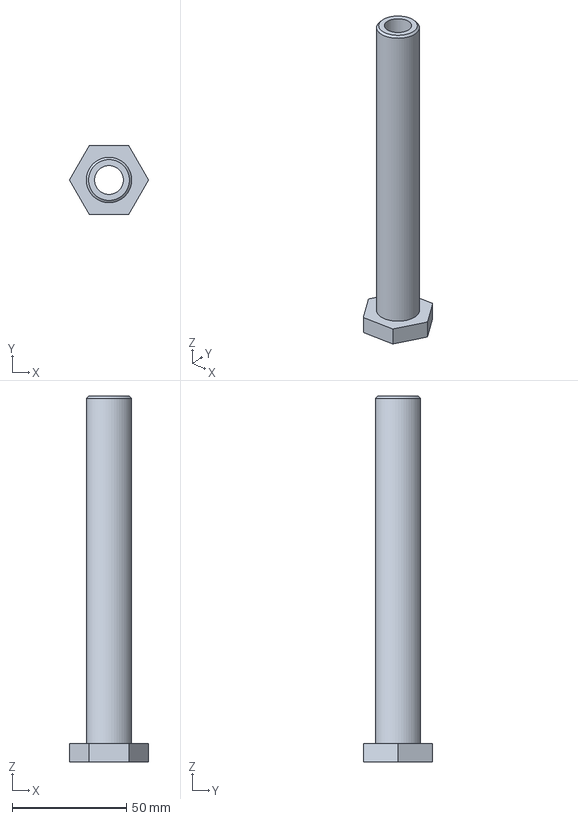
[picture p57: CAD file, 2026-10-12]
cad/out/step/caster_spindle_sleeve.step
34.6 x 30.0 x 160.0 mm
