MeckMan2025/LawnBot/cad/out/step/caster_axle_spacer_outer.step

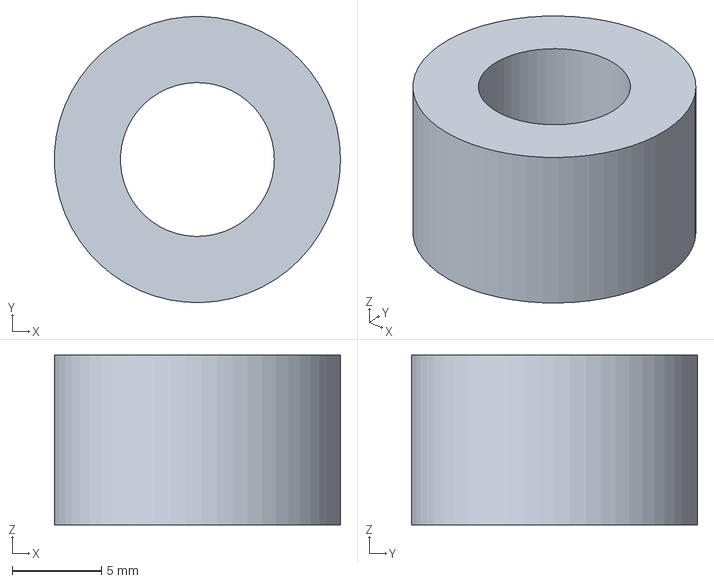
[picture p58: CAD file, 2026-10-12]
cad/out/step/caster_axle_spacer_outer.step
16.0 x 16.0 x 9.50 mm
