MeckMan2025/LawnBot/cad/out/step/skirt_rear.step

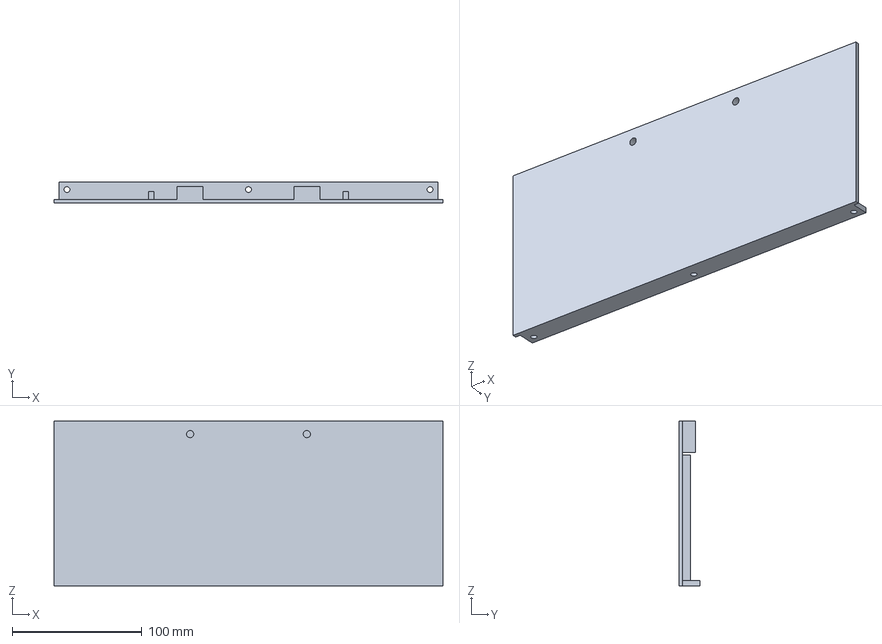
[picture p59: CAD file, 2026-10-12]
cad/out/step/skirt_rear.step
300.0 x 16.5 x 127.0 mm
