MeckMan2025/LawnBot/cad/out/step/deck_rear_right.step

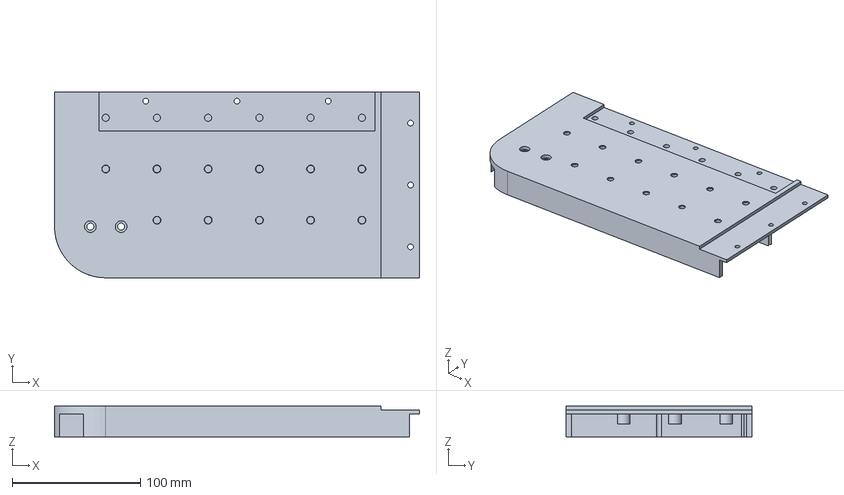
[picture p60: CAD file, 2026-10-12]
cad/out/step/deck_rear_right.step
285.0 x 145.0 x 24.0 mm
