MeckMan2025/LawnBot/cad/out/step/motor_mount_bracket.step

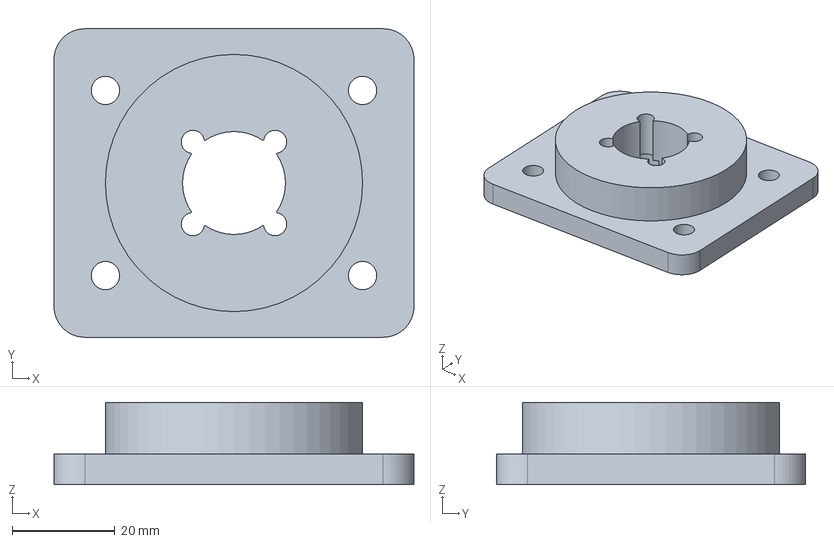
[picture p61: CAD file, 2026-10-12]
cad/out/step/motor_mount_bracket.step
70.0 x 60.0 x 16.0 mm
