MeckMan2025/LawnBot/cad/out/step/drive_tread.step

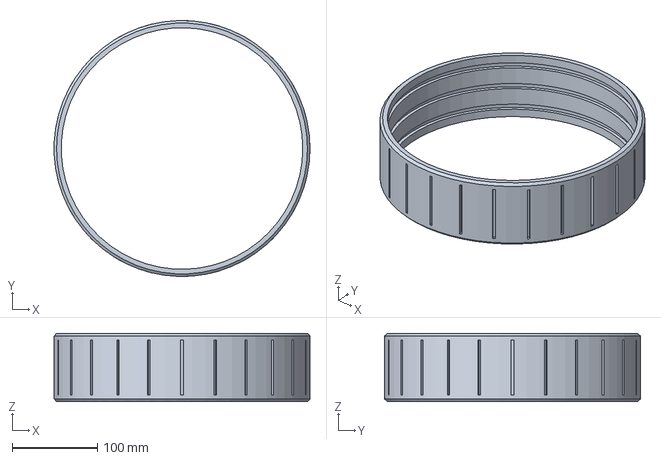
[picture p62: CAD file, 2026-10-12]
cad/out/step/drive_tread.step
300.0 x 300.0 x 80.0 mm
