MeckMan2025/LawnBot/(list of files, cad)

Other CAD files:
cad/out/step/chassis_module_front_right.step
cad/out/step/chassis_module_rear_left.step
cad/out/step/boom_arm_left.step
cad/out/step/canopy_rear_right.step
cad/out/step/canopy_front_left.step
cad/out/step/chassis_lid_front.step
cad/out/step/chassis_module_rear_right.step
cad/out/assembly.stl
cad/out/stl/alignment_dowel.stl
cad/out/stl/battery_tray.stl
cad/out/stl/bearing_spacer.stl
cad/out/stl/boom_arm_left.stl
cad/out/stl/boom_arm_right.stl
cad/out/stl/boom_cross_front_half.stl
cad/out/stl/boom_cross_rear_half.stl
cad/out/stl/bumper_carrier.stl
cad/out/stl/bumper_skin.stl
cad/out/stl/camera_cover.stl
cad/out/stl/camera_housing.stl
cad/out/stl/camera_window.stl
cad/out/stl/canopy_front_left.stl
cad/out/stl/canopy_front_right.stl
cad/out/stl/canopy_rear_left.stl
cad/out/stl/canopy_rear_right.stl
cad/out/stl/canopy_splice_roof_x.stl
cad/out/stl/canopy_splice_roof_y.stl
cad/out/stl/canopy_splice_wall.stl
cad/out/stl/caster_axle_spacer_inner.stl
cad/out/stl/caster_axle_spacer_outer.stl
cad/out/stl/caster_fork.stl
cad/out/stl/caster_rim.stl
cad/out/stl/caster_spindle_sleeve.stl
cad/out/stl/caster_spindle_tower.stl
cad/out/stl/caster_tire.stl
cad/out/stl/charge_port_housing.stl
cad/out/stl/chassis_lid_front.stl
cad/out/stl/chassis_lid_rear.stl
cad/out/stl/chassis_module_front_left.stl
cad/out/stl/chassis_module_front_right.stl
cad/out/stl/chassis_module_rear_left.stl
cad/out/stl/chassis_module_rear_right.stl
cad/out/stl/contact_pad_carrier.stl
cad/out/stl/deck_front_left.stl
cad/out/stl/deck_front_right.stl
cad/out/stl/deck_rear_left.stl
cad/out/stl/deck_rear_right.stl
cad/out/stl/dock_contact_block.stl
cad/out/stl/dock_rail_half.stl
cad/out/stl/dock_rain_cover.stl
cad/out/stl/dock_tag_frame.stl
cad/out/stl/dock_tile.stl
cad/out/stl/drive_axle_housing.stl
cad/out/stl/drive_tread.stl
cad/out/stl/drive_wheel.stl
cad/out/stl/enclosure_gasket.stl
cad/out/stl/enclosure_lid.stl
cad/out/stl/enclosure_tub.stl
cad/out/stl/estop_housing.stl
cad/out/stl/fender.stl
cad/out/stl/gps_mount.stl
cad/out/stl/light_bar_housing.stl
cad/out/stl/mast_base.stl
cad/out/stl/mast_segment.stl
cad/out/stl/mast_standoff.stl
cad/out/stl/motor_mount_bracket.stl
cad/out/stl/oak_hood.stl
cad/out/stl/oak_mount.stl
cad/out/stl/pan_base.stl
cad/out/stl/rear_deck_leg.stl
cad/out/stl/riser_brace.stl
cad/out/stl/riser_column.stl
cad/out/stl/skirt_front.stl
cad/out/stl/skirt_rear.stl
cad/out/stl/skirt_side_front.stl
cad/out/stl/skirt_side_rear.stl
cad/out/stl/tilt_bracket.stl
