MeckMan2025/LawnBot/docs/assembly-audit.md

# Virtual assembly audit

Generated by `cad/audit.py`. 68 placed parts, 160 fasteners checked.

| Check | Result |
|---|---|
| Insertion sweeps (part can reach its position in build order) | 68 of 68 clear |
| Bolt holes line up through every joined part | 160 of 160 clear |
| Driver can reach the bolt head at that point in the build | 160 of 160 clear |

## Build order used

- Step 1:
  - rear_left (chassis_module_rear_left), from (0, 0, 1)
  - rear_right (chassis_module_rear_right), from (0, 0, 1)
  - front_left (chassis_module_front_left), from (0, 0, 1)
  - front_right (chassis_module_front_right), from (0, 0, 1)
- Step 2:
  - motor_mount_left (motor_mount_bracket), from (0, -1, 0)
  - axle_housing_left (drive_axle_housing), from (0, 1, 0)
  - motor_mount_right (motor_mount_bracket), from (0, 1, 0)
  - axle_housing_right (drive_axle_housing), from (0, -1, 0)
  - lid_rear (chassis_lid_rear), from (0, 0, 1)
  - lid_front (chassis_lid_front), from (0, 0, 1)
  - wheel_left (drive_wheel), from (0, 1, 0)
  - tread_left (drive_tread), from (0, 1, 0)
  - wheel_right (drive_wheel), from (0, -1, 0)
  - tread_right (drive_tread), from (0, -1, 0)
- Step 3:
  - leg_left (rear_deck_leg), from (0, 0, 1)
  - leg_right (rear_deck_leg), from (0, 0, 1)
  - battery_tray (battery_tray), from (0, 0, 1)
  - skirt_rear (skirt_rear), from (-1, 0, 0)
  - skirt_front (skirt_front), from (0, 0, 1)
  - skirt_side_rear_left (skirt_side_rear), from (0, 0, 1)
  - skirt_side_front_left (skirt_side_front), from (0, 0, 1)
  - skirt_side_rear_right (skirt_side_rear), from (0, 0, 1)
  - skirt_side_front_right (skirt_side_front), from (0, 0, 1)
- Step 4:
  - riser_left (riser_column), from (0, 0, 1)
  - cross_rear_left (boom_cross_rear_half), from (0, 0, 1)
  - riser_right (riser_column), from (0, 0, 1)
  - cross_rear_right (boom_cross_rear_half), from (0, 0, 1)
  - brace_left (riser_brace), from (0, 0, 1)
  - boom_arm_left (boom_arm_left), from (0, 0, 1)
  - brace_right (riser_brace), from (0, 0, 1)
  - boom_arm_right (boom_arm_right), from (0, 0, 1)
  - cross_front_left (boom_cross_front_half), from (0, 0, 1)
  - cross_front_right (boom_cross_front_half), from (0, 0, 1)
- Step 5:
  - tower_left (caster_spindle_tower), from (0, 0, 1)
  - sleeve_left (caster_spindle_sleeve), from (0, 0, -1)
  - fork_left (caster_fork), from (0, 0, -1)
  - caster_rim_left (caster_rim), from (1, 0, 0)
  - caster_tire_left (caster_tire), from (1, 0, 0)
  - tower_right (caster_spindle_tower), from (0, 0, 1)
  - sleeve_right (caster_spindle_sleeve), from (0, 0, -1)
  - fork_right (caster_fork), from (0, 0, -1)
  - caster_rim_right (caster_rim), from (1, 0, 0)
  - caster_tire_right (caster_tire), from (1, 0, 0)
- Step 6:
  - deck_rear_right (deck_rear_right), from (0, 0, 1)
  - deck_rear_left (deck_rear_left), from (0, 0, 1)
  - deck_front_right (deck_front_right), from (0, 0, 1)
  - deck_front_left (deck_front_left), from (0, 0, 1)
  - enclosure_tub (enclosure_tub), from (0, 0, 1)
  - enclosure_lid (enclosure_lid), from (0, 0, 1)
  - mast_standoff (mast_standoff), from (0, 0, 1)
- Step 7:
  - canopy_front_left (canopy_front_left), from (0, 0, 1)
  - canopy_front_right (canopy_front_right), from (0, 0, 1)
  - canopy_rear_left (canopy_rear_left), from (0, 0, 1)
  - canopy_rear_right (canopy_rear_right), from (0, 0, 1)
  - fender_left (fender), from (0, 0, 1)
  - fender_right (fender), from (0, 0, 1)
  - bumper_carrier (bumper_carrier), from (1, 0, 0)
  - bumper_skin (bumper_skin), from (1, 0, 0)
  - oak_mount (oak_mount), from (1, 0, 0)
  - estop_housing (estop_housing), from (0, 0, 1)
  - light_bar_housing (light_bar_housing), from (-1, 0, 0)
- Step 8:
  - mast_base (mast_base), from (0, 0, 1)
  - mast_segment_0 (mast_segment), from (0, 0, 1)
  - mast_segment_1 (mast_segment), from (0, 0, 1)
  - pan_base (pan_base), from (0, 0, 1)
  - tilt_bracket (tilt_bracket), from (0, 0, 1)
  - camera_housing (camera_housing), from (1, 0, 0)
  - gps_mount (gps_mount), from (-1, 0, 0)

## Fasteners checked

| Fastener | Size | Count |
|---|---|---|
| seam bolt (lateral) | M5 | 8 |
| seam bolt (longitudinal) | M5 | 8 |
| lid bolt | M4 | 20 |
| axle housing bolt | M5 | 8 |
| motor bolt | M4 | 8 |
| riser foot bolt | M5 | 8 |
| riser top bolt | M5 | 4 |
| brace foot bolt | M5 | 4 |
| brace to riser bolt | M5 | 4 |
| leg foot bolt | M5 | 8 |
| arm to rear cross bolt | M5 | 4 |
| arm pad to front cross bolt | M5 | 4 |
| cross splice bolt | M5 | 4 |
| tower bolt | M6 | 8 |
| spindle bolt (insert before the wheel) | M12 | 2 |
| caster axle bolt | M8 | 2 |
| deck to cross member bolt | M5 | 8 |
| deck to leg bolt | M5 | 4 |
| enclosure foot bolt | M4 | 4 |
| battery tray bolt | M4 | 4 |
| side skirt bolt | M4 | 8 |
| rear skirt bolt | M4 | 3 |
| front skirt bolt | M4 | 3 |
| canopy to skirt screw | M4 | 8 |
| fender bolt | M4 | 6 |
| mast standoff bolt | M4 | 4 |
| mast base bolt | M5 | 4 |
