MeckMan2025/LawnBot/docs/guide/index.html

# LawnBot

A fully 3D-printed outdoor patrol robot. Take it for a drive: click the yard, then W A S D or the arrow keys. Drag to look around, scroll to zoom. It reports what it finds as it passes the porch, the side gate, the mailbox and the shed.

Reset

0.00 m/sPatrol idle. Waiting for a driver.

▲◀▼▶

loading models...

## Build guide

Every printed part, in build order, with a 3D view of where it goes. Orange parts are the ones you fit in the current step; grey parts are already on. Blue shapes are bought parts (motors, battery). Drag to orbit, scroll to zoom, right-drag to pan.

68printed part designs

...pieces to print

...kg of filament (est.)

160bolts checked for fit and tool access

loading models...

this stepalready fittedbought part

Explode this step Show earlier parts Fit view 3/4TopSide

Previous stepNext step

## Every printed part

Click a part to see it alone in the viewer. Sizes are the printed footprint in mm; mass is estimated from the volume and the recommended infill.
