MeckMan2025/LawnBot/(commit log)

2026-10-12 ClaudeBot: parametric CAD, virtual build audit, build guide and site
    Fully 3D-printed outdoor patrol robot. 68 CadQuery parts with STEP and STL
    output, assembly and interference check, insertion/bolt/driver-access audit,
    print guide, BOM, and the illustrated build guide deployed to
    lawnbot.meckman.org.
    [BOM.csv, alignment_dowel.step, alignment_dowel.stl, assembly.step, assembly.stl, battery_tray.step, battery_tray.stl, bearing_spacer.step]
2026-10-13 Rename to LawnBot; add drivable yard simulator hero
    The build guide now opens with the assembled robot in a yard scene (house,
    driveway, beds, trees, fences, shed, dock) that the viewer drives with WASD
    or arrow keys. Differential-drive kinematics, spinning wheels, trailing
    casters, collisions, and patrol check-ins at the porch, gate, mailbox and
    shed. Repo and docs renamed from ClaudeBot to LawnBot.
2026-10-13 Regenerate assembly.step under the LawnBot name
    [assembly.step]
